Ye-Htet-Kyaw/Prototyping-D4-Abdelmalek-Kyaw-Forbi-Tchouteng/media/Wiring/1000001931.jpg

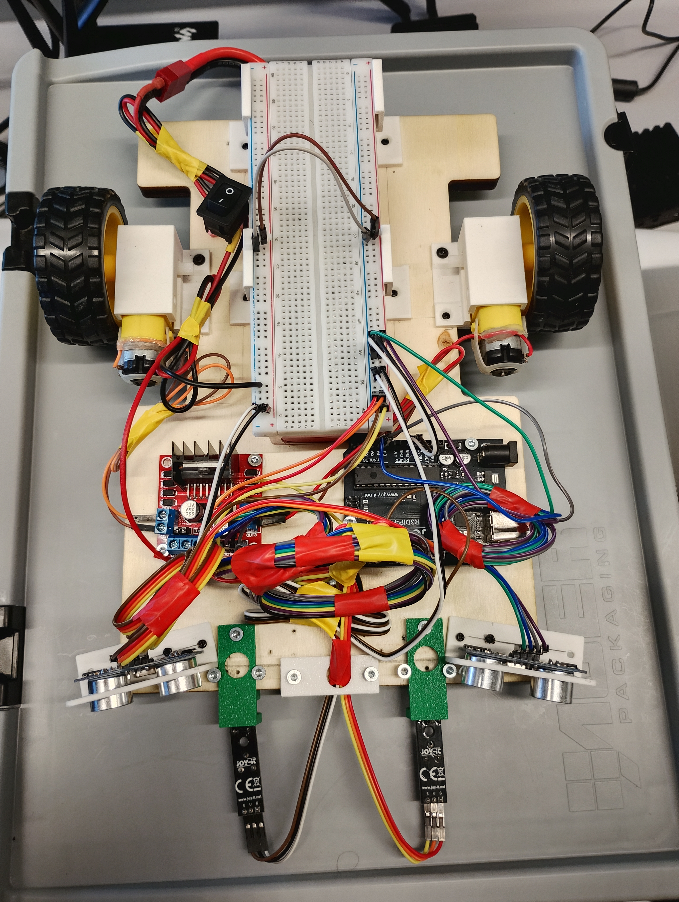
media/Wiring/1000001931.jpg
