Ye-Htet-Kyaw/Prototyping-D4-Abdelmalek-Kyaw-Forbi-Tchouteng/media/Wiring/part 2/IMG_7180.jpeg

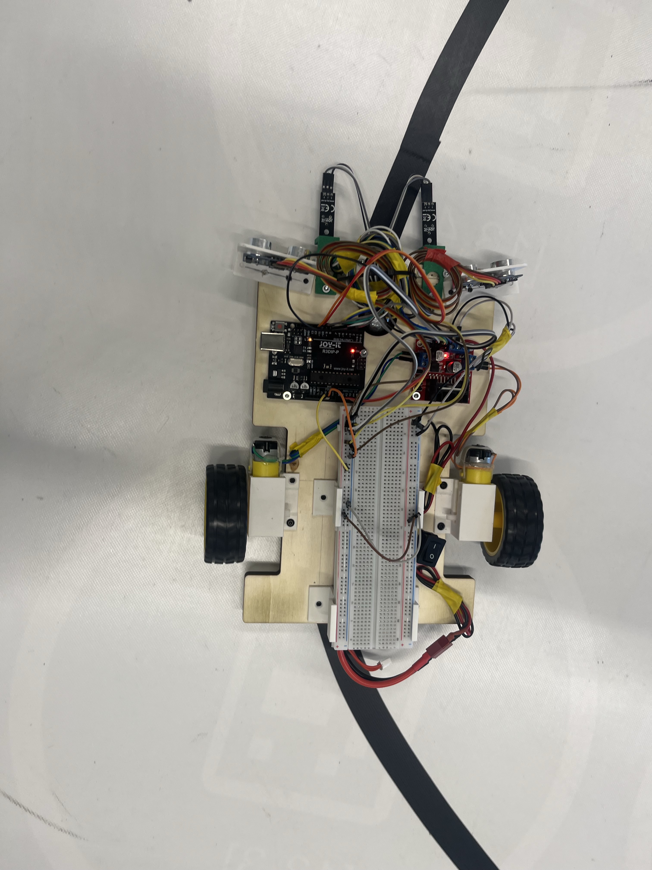
media/Wiring/part 2/IMG_7180.jpeg
