Ye-Htet-Kyaw/Prototyping-D4-Abdelmalek-Kyaw-Forbi-Tchouteng/Firmware and Simulation/README.md

# Module Definitions

| Module | Responsibility |
| :--- | :--- |
| **`RobotCar.ino`** | Main entry point; acts as the high-level task scheduler. |
| **`LineFollow.cpp`** | Contains the state machine logic for track navigation (Rules 1-4). |
| **`Obstacle.cpp`** | Manages complex maneuver sequences and obstacle avoidance states. |
| **`Motors.cpp`** | Low-level hardware driver; handles PWM and H-bridge signals. |
| **`Sensors.cpp`** | Interface for Ultrasonic and IR sensor data acquisition. |
| **`Config.h`** | Centralized constants (pins, speeds, thresholds, timing). |
