Ye-Htet-Kyaw/Prototyping-D4-Abdelmalek-Kyaw-Forbi-Tchouteng/CAD/Battery & Board/README.txt

Battery & Breadboard Holder – Work In Progress...

Current progress images of the custom CAD-designed holder for the breadboard and battery integration.

Initial geometry and mounting structure have been completed using CAD O-Shape for concept development.

Final refined version, including SolidWorks source files and exported STEP/STL manufacturing files, will be uploaded within the next 1–2 days.
