Ye-Htet-Kyaw/Prototyping-D4-Abdelmalek-Kyaw-Forbi-Tchouteng/CAD/Battery & Board/Battery_Board_Holder_Final_RevA/README.txt

Tolerance-adjusted final revision for improved component fit and assembly clearance.

Files:
- SLDPRT: Native SolidWorks model
- STL: 3D-printable mesh
- STEP: Neutral CAD exchange format

Minor dimensional tolerances were added to improve breadboard and battery accommodation.
