Ye-Htet-Kyaw/Prototyping-D4-Abdelmalek-Kyaw-Forbi-Tchouteng/docs/Final Presentation docs/first_draft/Team_D4.pptx

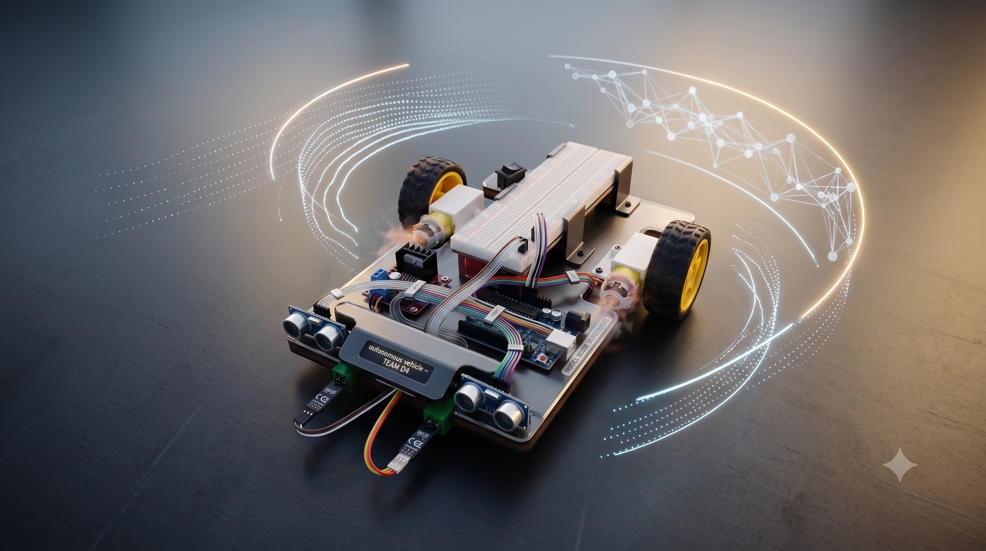
[picture p25: figure]

## Slide 2

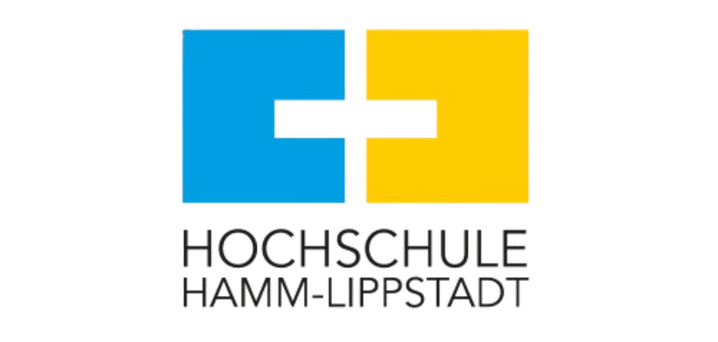
[picture p26: figure]

ELECTRICAL ENGINEERING | ELE

DESIGN AND IMPLEMENTATION OF AN AUTONOMOUS LINE-FOLLOWING AND OBSTACLE-AVOIDING ROBOT

Presented by ;

  - Dodly Forbi
  - Ye-Htet_Kyaw
  - Gabriel Tchakunte
  - Abdelmalek Abraham

ELE Systems Engineering SS2026

## Slide 3

Slide 1

PRESENTATION OUTLINE

  - Project objectives & Requirements
  - System Engineering View
  - Hardware and Mechanical Design
  - Software and Control Logic
  - UML Diagrams
  - Testing and Results
  - Conclusion
  - Future Work

## Slide 4

Slide 2

PROJECT OBJECTIVES & REQUIREMENTS

OBJECTIVES

  - Line Following

Follow straight and curved tracks

  - Obstacle Detection and varied behaviour ;

Perform alternating responses such as obstacle dodging and 180° turn

CONSTRAINTS

  - Arduino Uno only

  - Kit Components only including ;

  - A pair of Ultrasonic & IR sensors, L298N motor driver , 2 motors, breadboard , screws, wires and a custom chassis

  - Custom track
  - Environment

## Slide 5

Slide 3

SYSTEM ENGINEERING VIEW

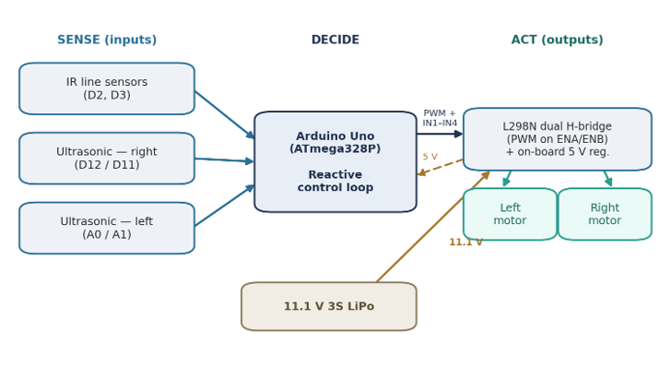
[picture p27: figure]

Inputs
  - 2× IR sensors
  - 2× HC-SR04 sensors
Controller
  - Arduino Uno
Outputs
  - L298N motor driver
  - Differential drive motors
Power
  - 11.1V LiPo

## Slide 6

ELECTRICAL ENGINEERING | ELE

Slide 4

HARDWARE AND MECHANICAL DESIGN

Presented by ;

  - Dodly Forbi
  - Ye-Htet_Kyaw
  - Gabriel Tchakunte
  - Abdelmalek Abraham

ELE Systems Engineering SS2026

## Slide 7

HARDWARE IMPLEMENTATION (1/5)

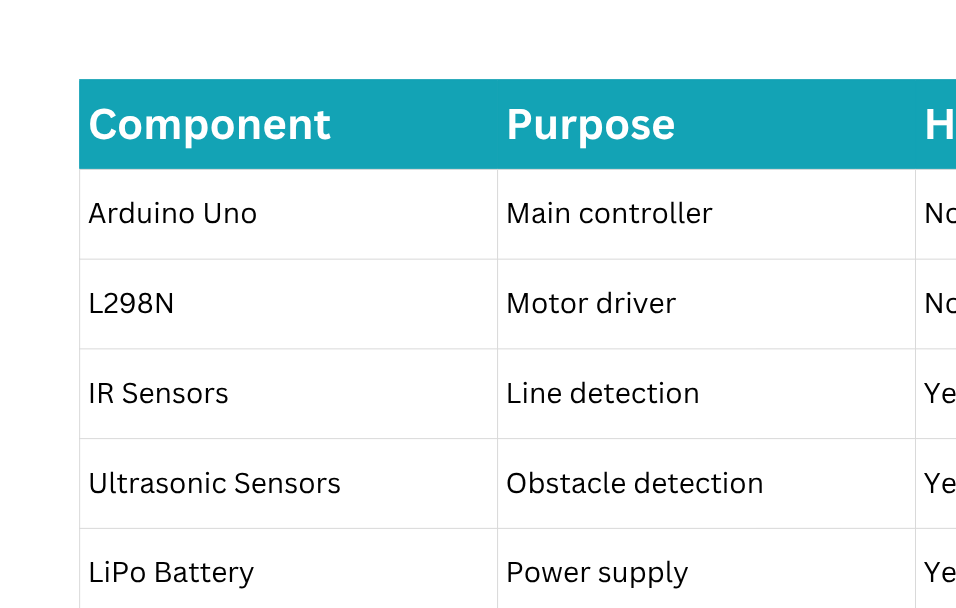
[picture p28: figure]

Slide 5

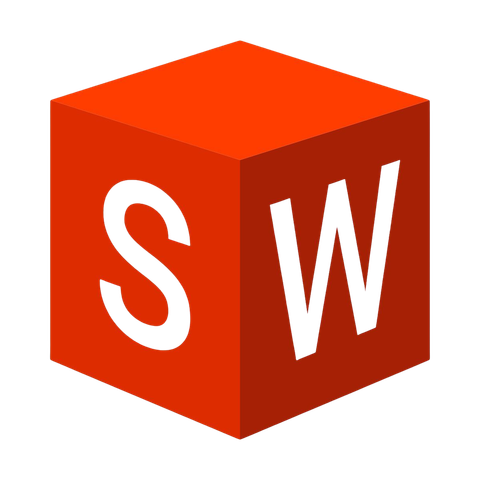
[picture p29: figure]
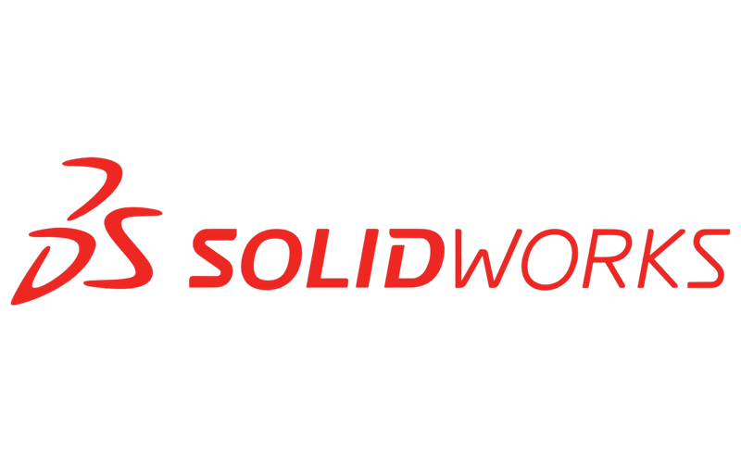
[picture p30: figure]

Mounts and Holders were designed on SolidWorks and then printed

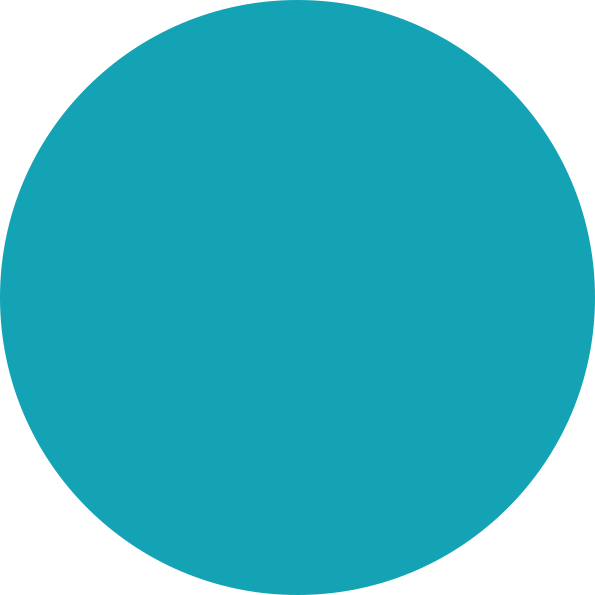
[picture p31: figure]

## Slide 8

HARDWARE IMPLEMENTATION (2/5)

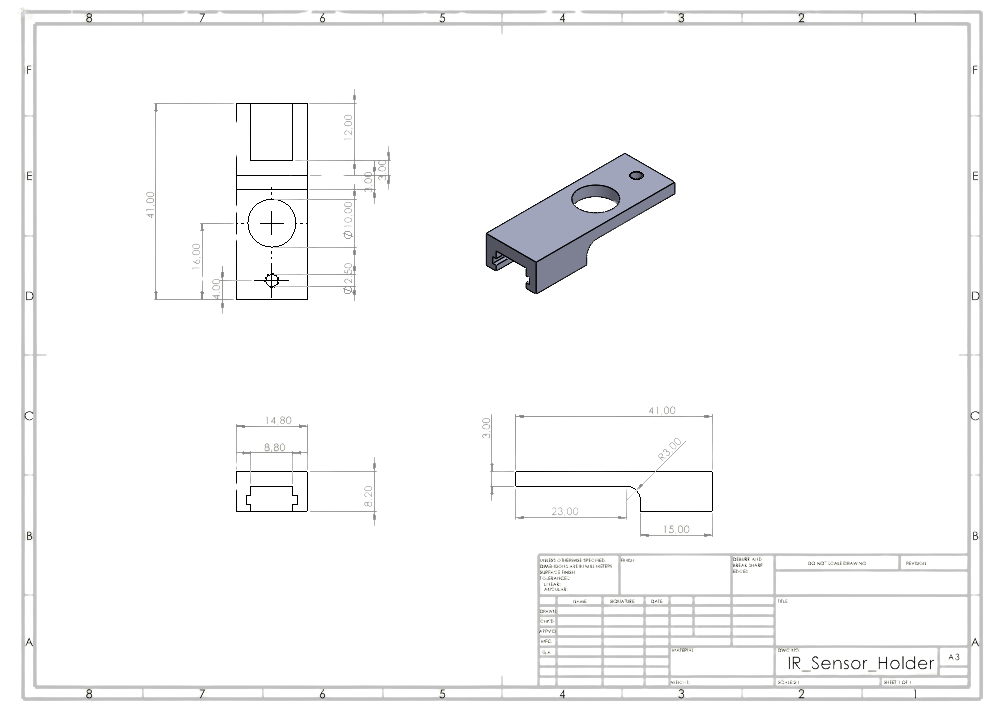
[picture p32: figure]

Slide 6

  - IR sensor Holder

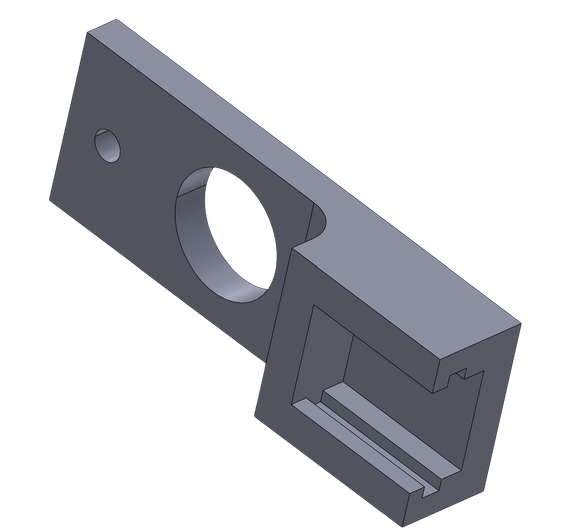
[picture p33: figure]

Ye

Ye Htet Tchew

## Slide 9

HARDWARE IMPLEMENTATION (3/5)

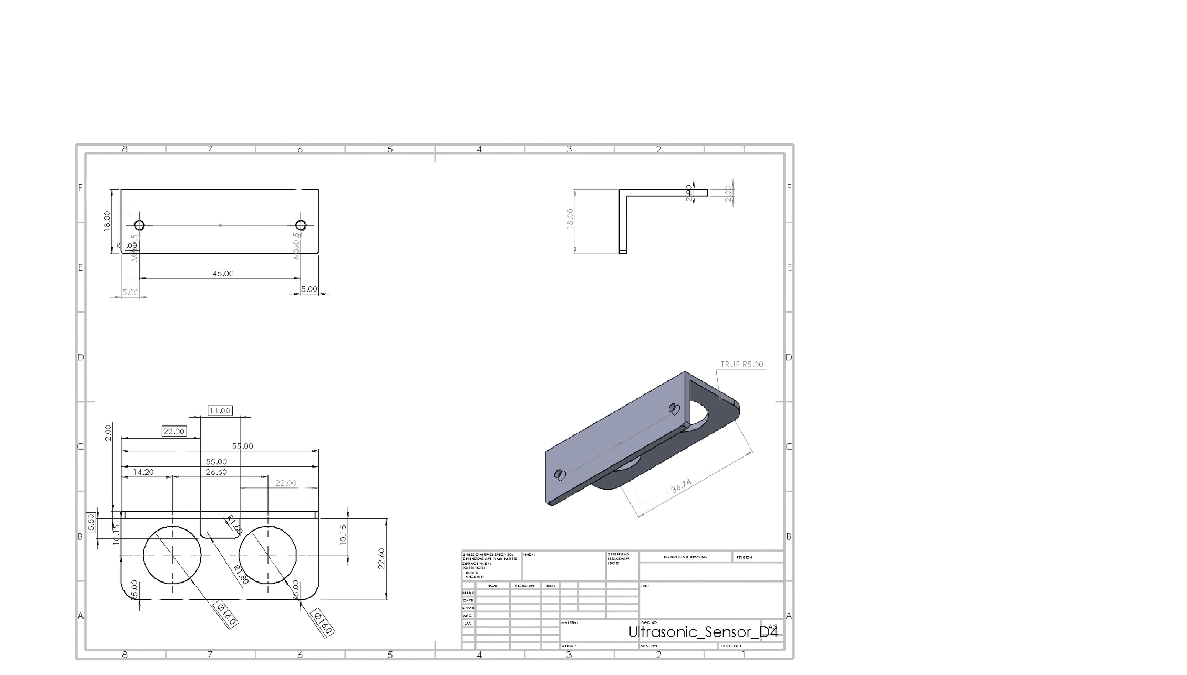
[picture p34: figure]

Slide 7

  - Ultrasonic Sensor Holder

Gabriel Tchakunte

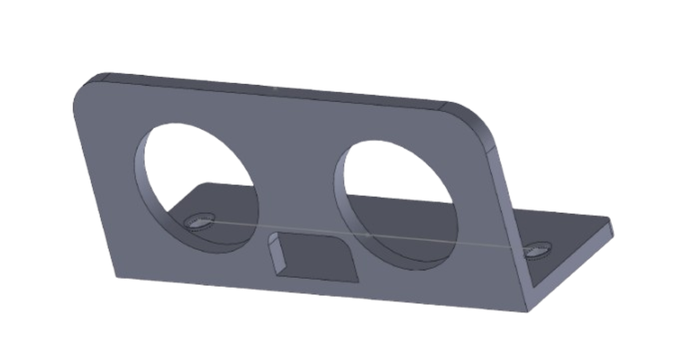
[picture p35: figure]
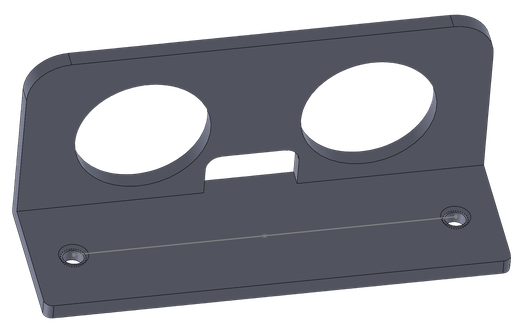
[picture p36: figure]

## Slide 10

HARDWARE IMPLEMENTATION (4/5)

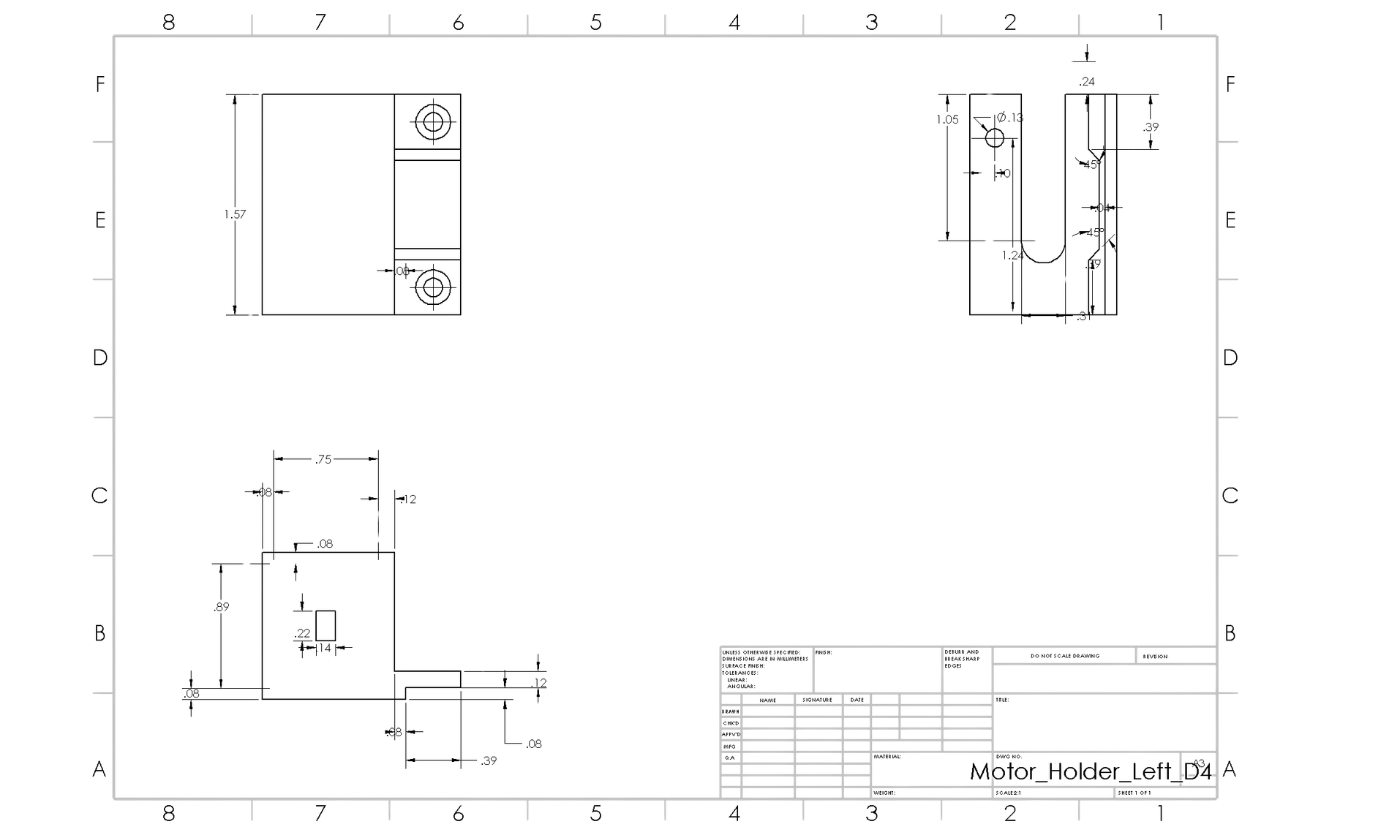
[picture p37: figure]

Slide 8

  - Ultrasonic Sensor

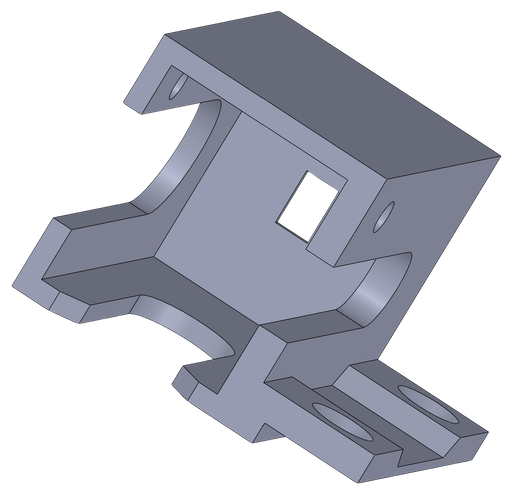
[picture p38: figure]

Abdelmalek Abraham

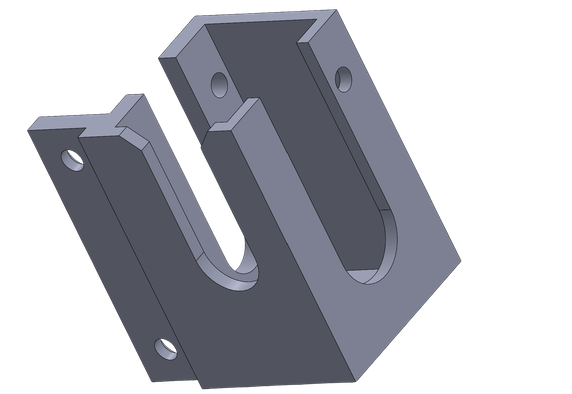
[picture p39: figure]

## Slide 11

HARDWARE IMPLEMENTATION (5/5)

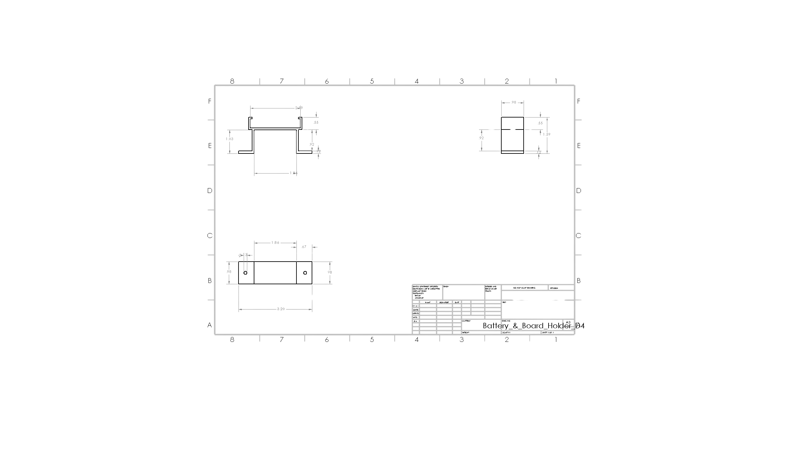
[picture p40: figure]

Slide 9

  - Battery/Breadboard Holder

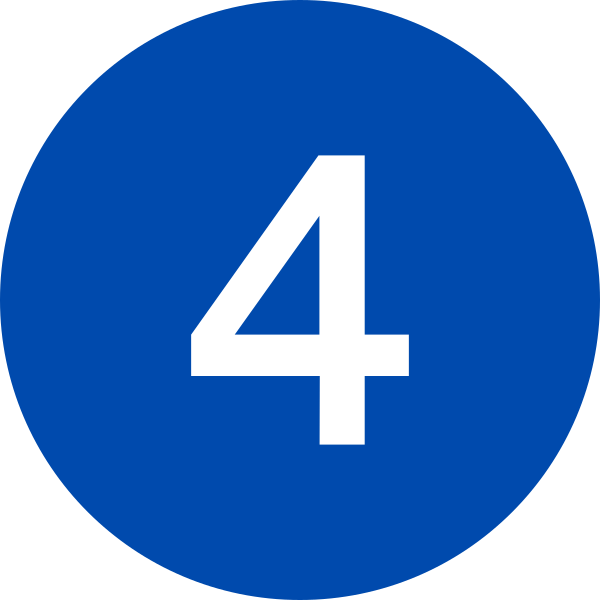
[picture p41: figure]
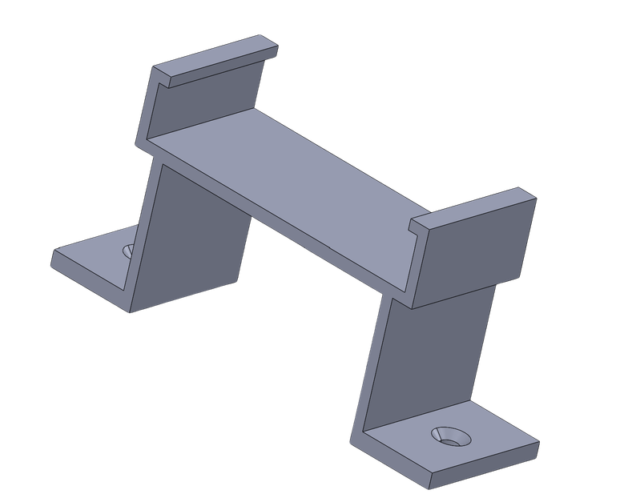
[picture p42: figure]
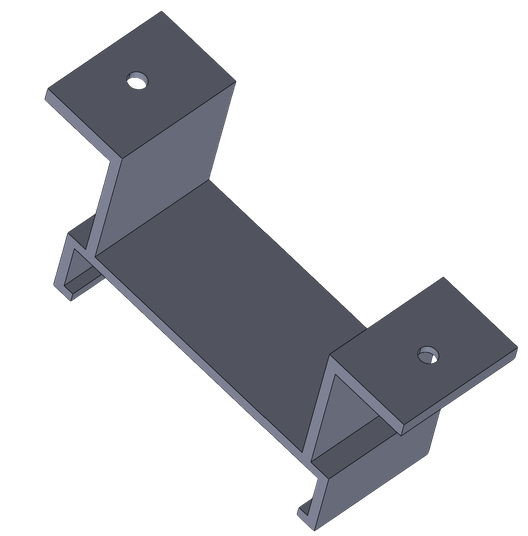
[picture p43: figure]

Dodly Forbi

## Slide 12

SOFTWARE & CONTROL LOGIC (1/3)

Slide 10

  - Two ultrasonic sensors checked every 60 ms
  - Closest distance triggers obstacle response at 12 cm
  - is180 alternates V-dogleg and 180° turn

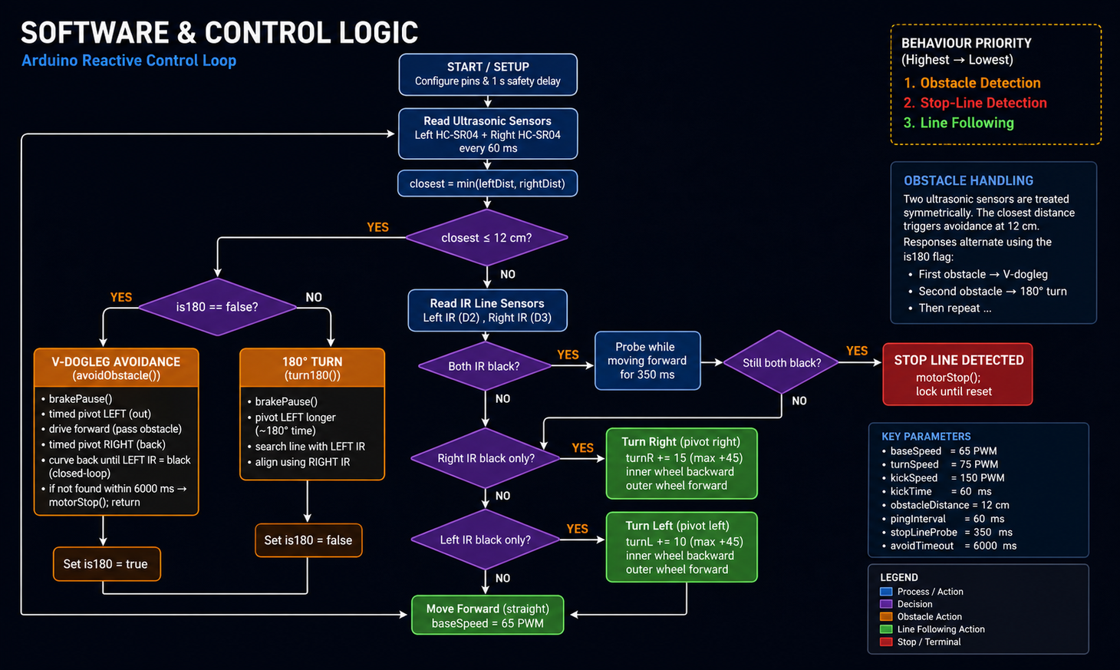
[picture p44: figure]
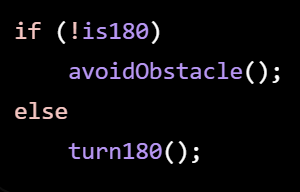
[picture p45: figure]

## Slide 13

SOFTWARE & CONTROL LOGIC (2/3)

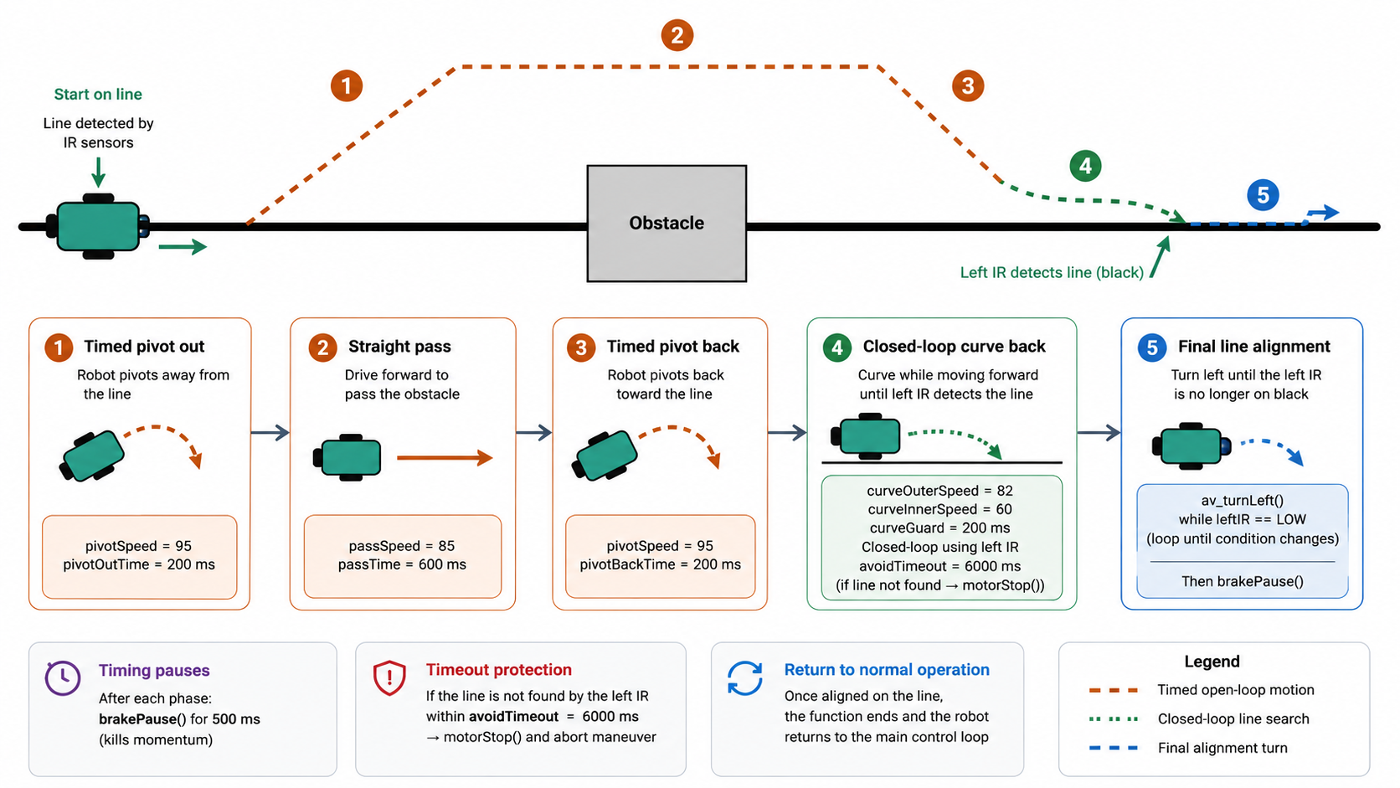
[picture p46: figure]

Slide 11

  - V dogleg dodge

## Slide 14

SOFTWARE & CONTROL LOGIC (3/3)

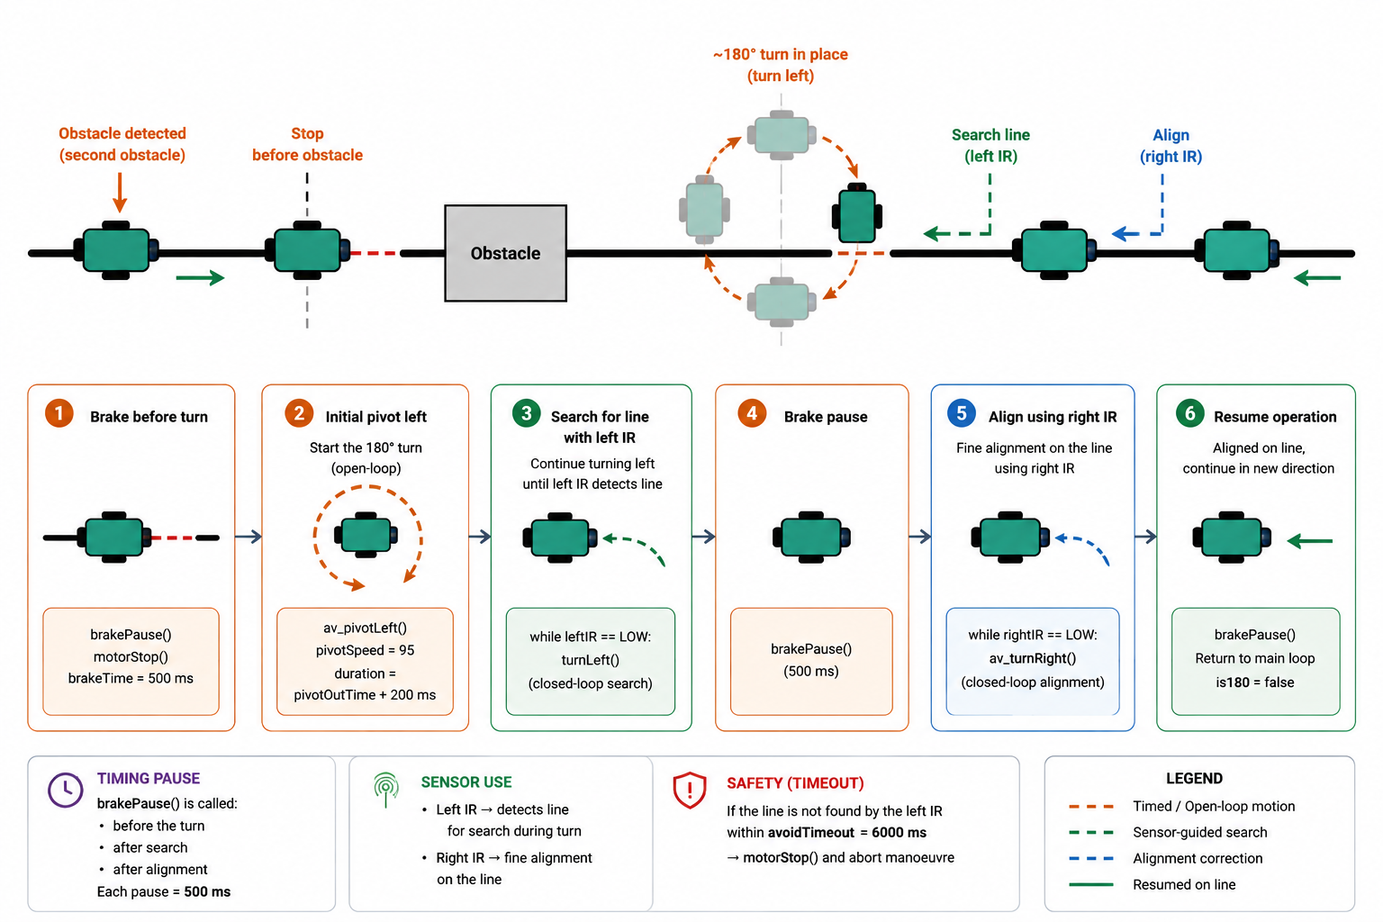
[picture p47: figure]

Slide 12

  - 180° turn

## Slide 15

ELECTRICAL ENGINEERING | ELE

Slide 13

UML DIAGRAMS

Presented by ;

  - Dodly Forbi
  - Ye-Htet_Kyaw
  - Gabriel Tchakunte
  - Abdelmalek Abraham

ELE Systems Engineering SS2026

## Slide 16

USE CASE DIAGRAM

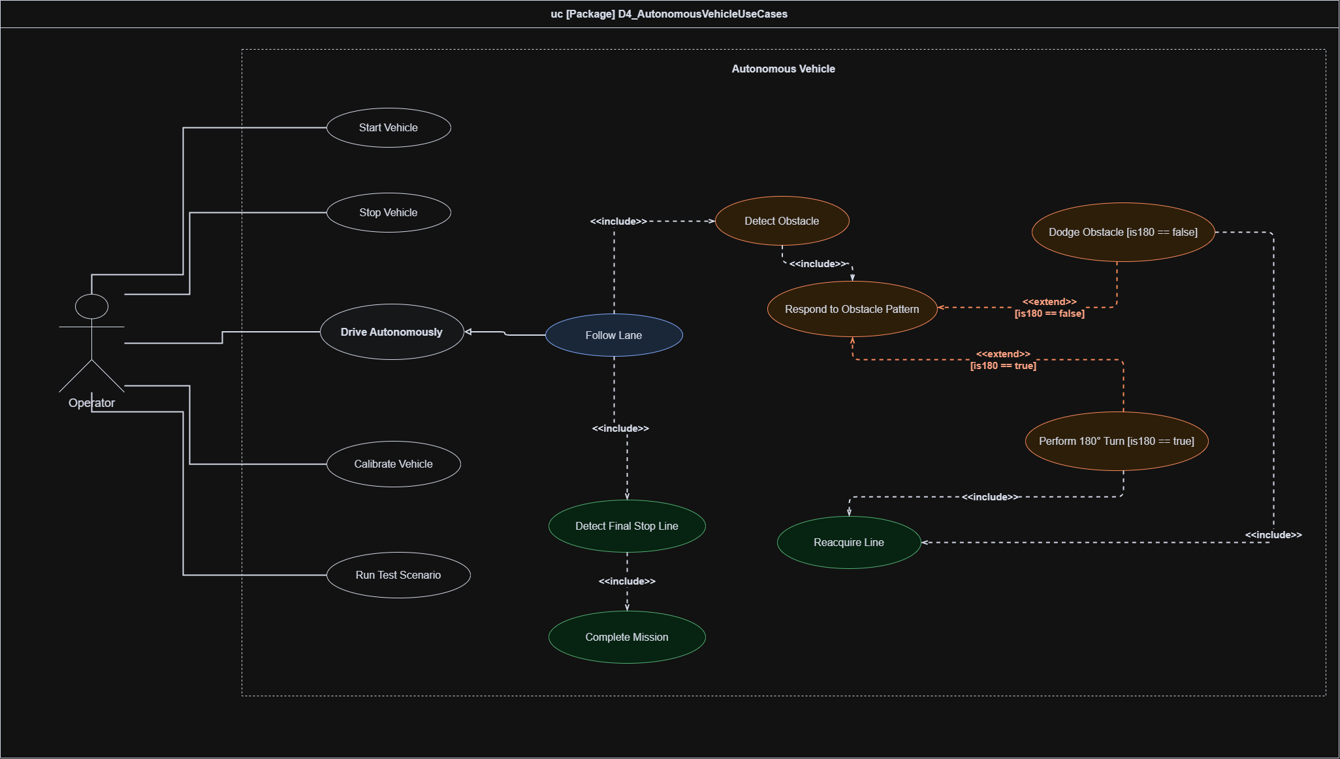
[picture p48: figure]

Slide 14

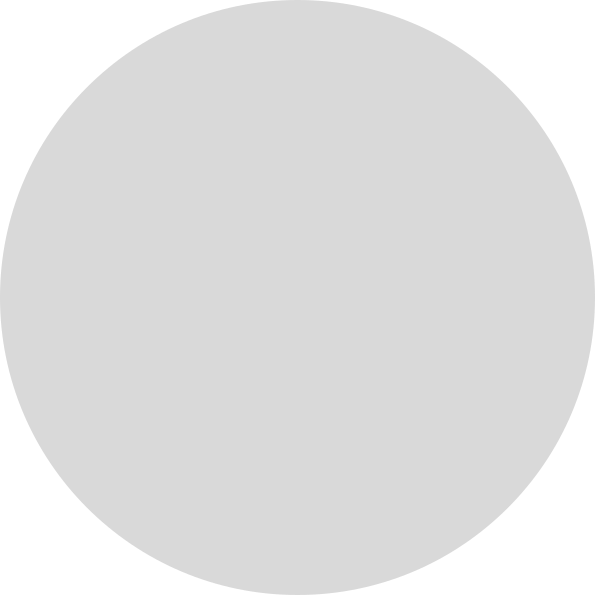
[picture p49: figure]
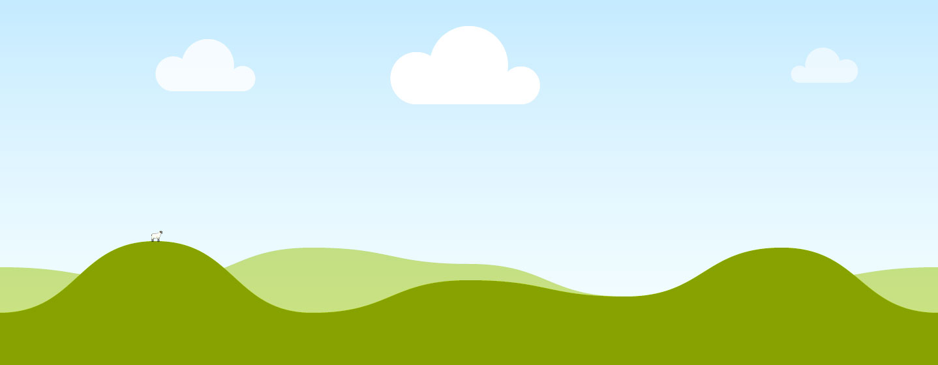
[picture p50: figure]

## Slide 17

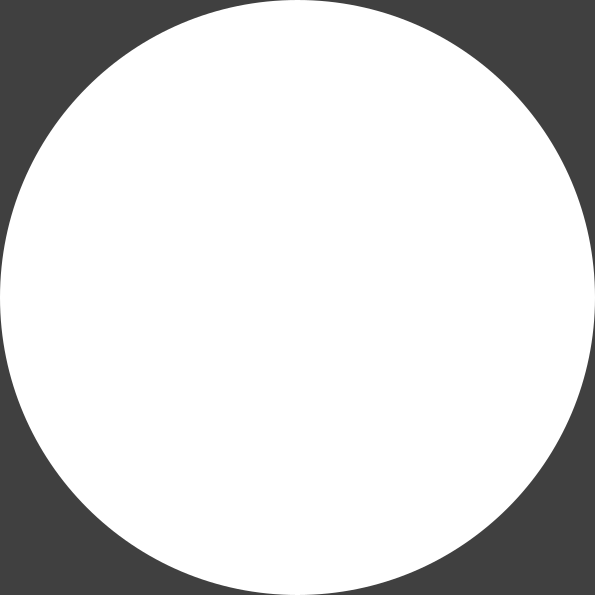
[picture p51: figure]

Slide 15

STATE MACHINE
DIAGRAM

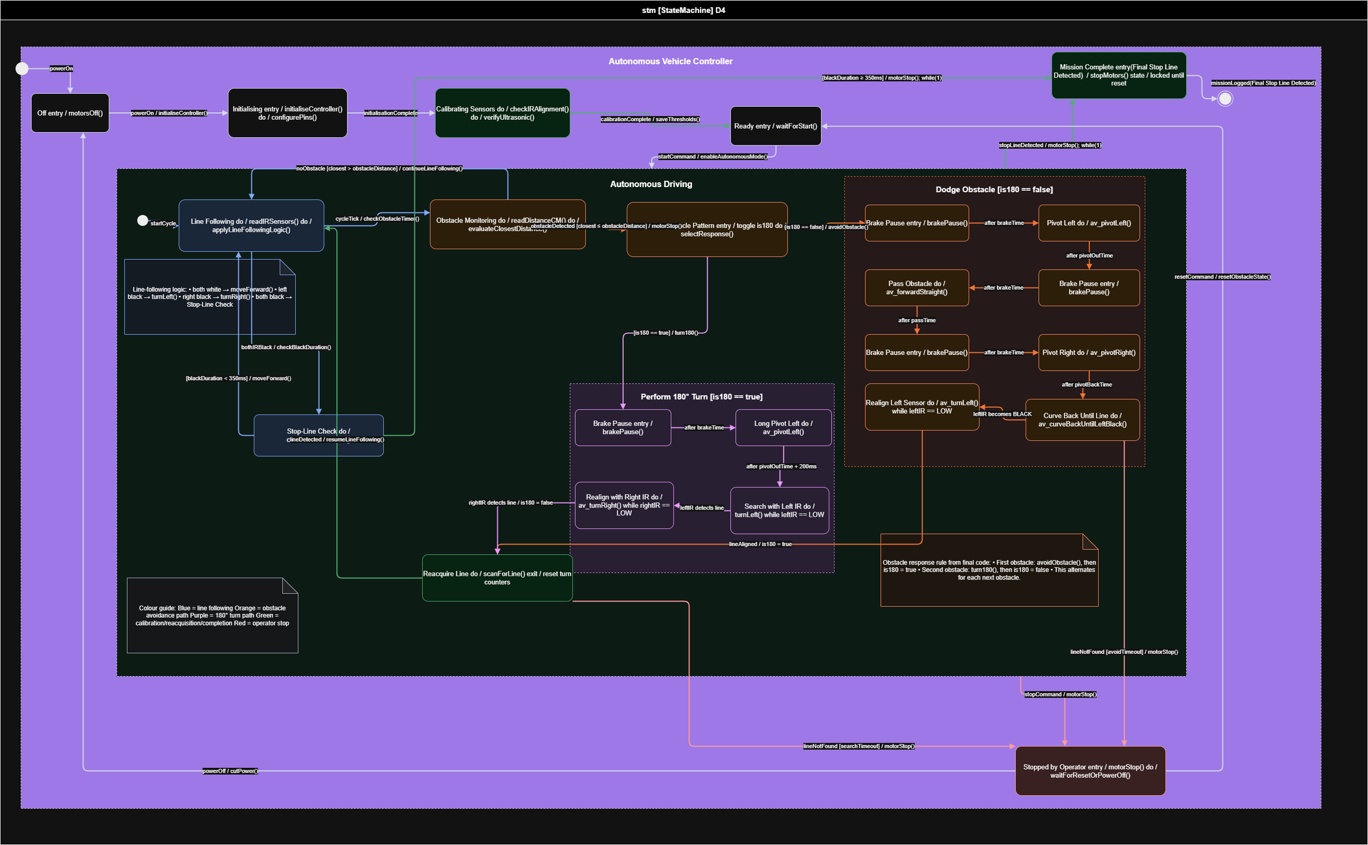
[picture p52: figure]

## Slide 18

ACTIVITY DIAGRAM

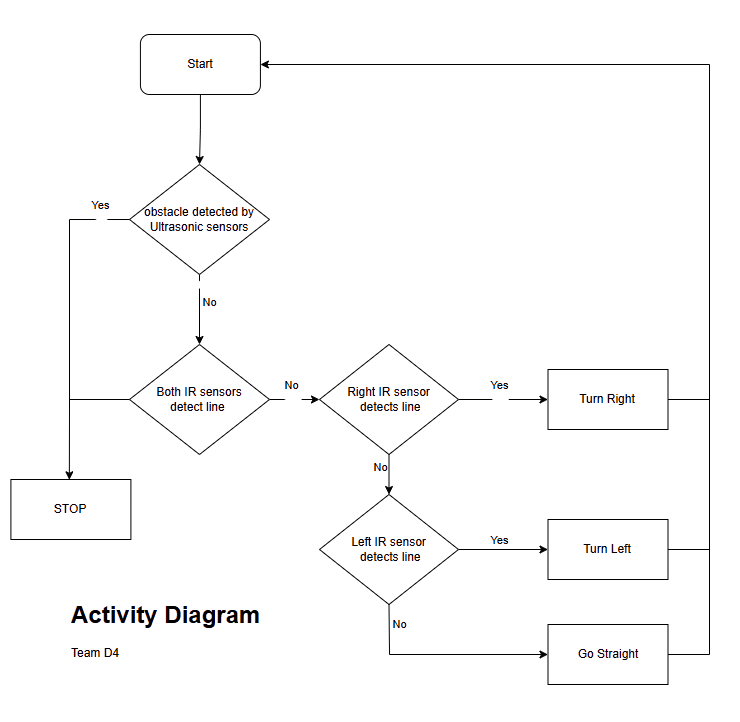
[picture p53: figure]

Slide 16

## Slide 19

PACKAGE DIAGRAM

Slide 17

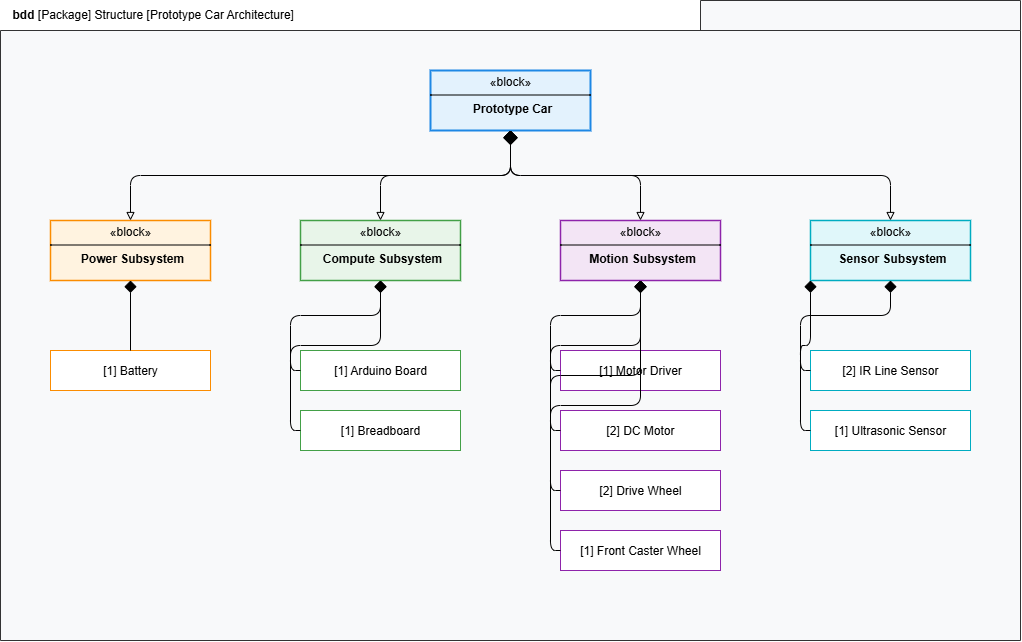
[picture p54: figure]

## Slide 20

BLOCK COMPONENT DIAGRAM

Slide 18

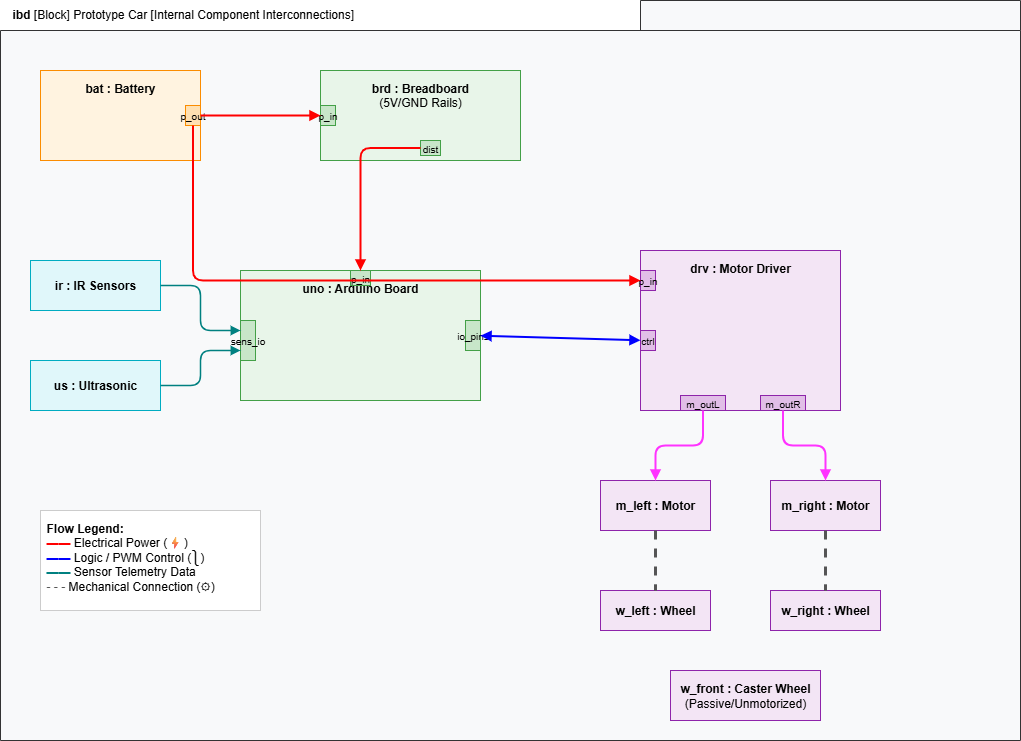
[picture p55: figure]

## Slide 21

SEQUENCE DIAGRAM

Slide 19

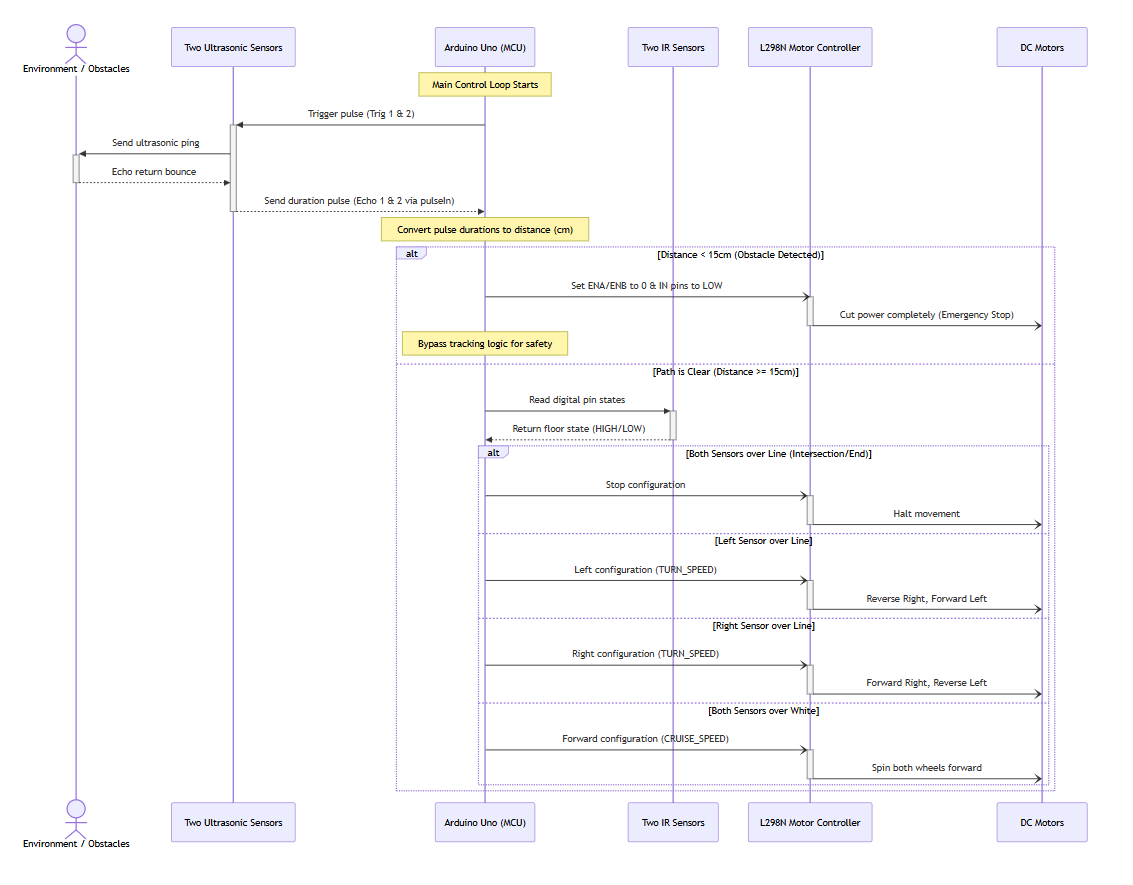
[picture p56: figure]

## Slide 22

TESTING & RESULTS

Slide 20

Test Photo #1

Test Photo #2

Test Photo #3

## Slide 23

TESTING & RESULTS (2/2)

Slide 21

RESULTS

  - Motor completed track in 48secs without obstacle manoeuvring
  - Static friction required kick-start PWM.
  - Physical testing outperformed simulation.
  - Sensor placement mattered more than expected.
  - Mechanical robustness required multiple redesigns.

## Slide 24

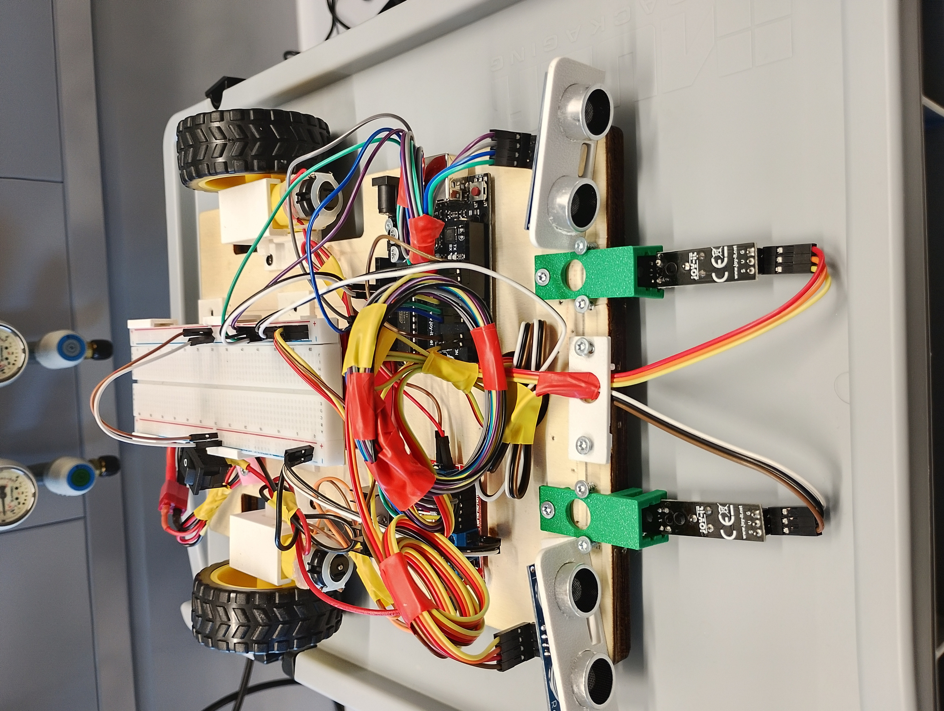
[picture p57: figure]

CONCLUSIONS

ACHIEVEMENTS

✅Met all objectives
✅ Used only project-kit hardware
✅ Reliable autonomous behaviour
✅ Complete documentation
✅ Team Collaboration on Github

Slide 22

## Slide 25

Slide 23

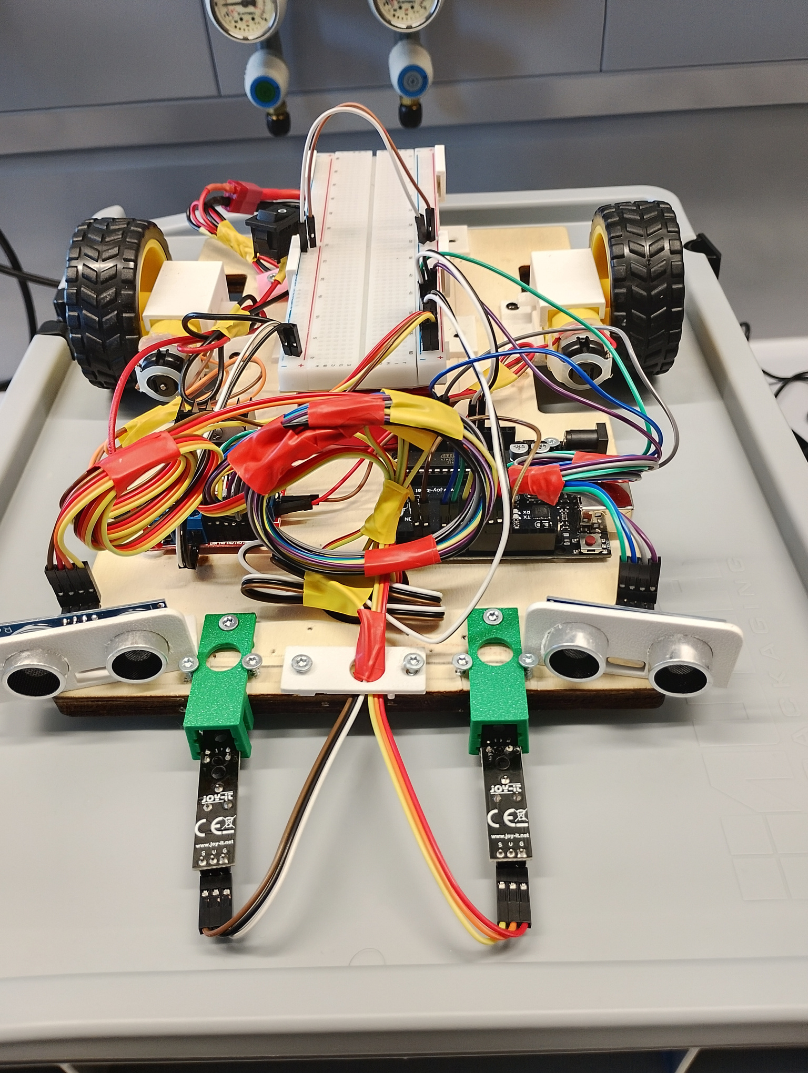
[picture p58: figure]

FUTURE WORK

  - PID line following
  - Wheel encoders
  - Adaptive IR calibration
  - Vision-based navigation

## Slide 26

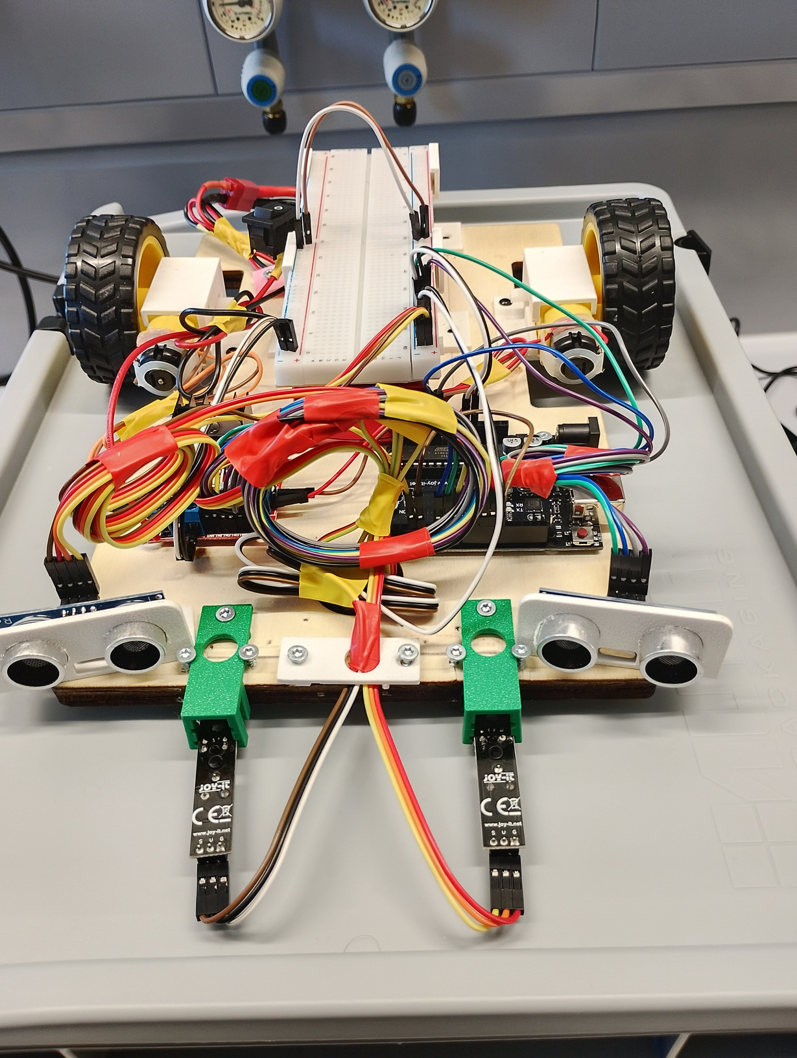
[picture p59: figure]

Thank
You

for your keen attention.

Questions , comments ?
