Ye-Htet-Kyaw/Prototyping-D4-Abdelmalek-Kyaw-Forbi-Tchouteng/Tasks/Splitings_Tasks.md

<table border="1" style="border-collapse: collapse; width: 100%; font-family: Arial, sans-serif; font-size: 14px;">
  <thead>
    <tr>
      <th style="padding: 10px; text-align: center;"></th>
      <th style="padding: 10px; text-align: center;"></th>
      <th style="padding: 10px; text-align: center;"></th>
      <th style="padding: 10px; text-align: center;" colspan="2">Ye Htet Kyaw</th>
      <th style="padding: 10px; text-align: center;" colspan="2">Ibrahim Abdelmalek</th>
      <th style="padding: 10px; text-align: center;" colspan="2">Dodly Forbi</th>
      <th style="padding: 10px; text-align: center;" colspan="2">Gabriel Tchakunte Tchouteng</th>
    </tr>
  </thead>
  <tbody>
    <tr>
      <td style="padding: 10px; text-align: center;">Number</td>
      <td style="padding: 10px; text-align: center;">Task</td>
      <td style="padding: 10px; text-align: center;">Short Summary</td>
      <td style="padding: 10px; text-align: center;">To Do <br>(Dead line)</td>
      <td style="padding: 10px; text-align: center;">Finishing Date</td>
      <td style="padding: 10px; text-align: center;">To Do <br>(Dead line)</td>
      <td style="padding: 10px; text-align: center;">Finishing Date</td>
      <td style="padding: 10px; text-align: center;">To Do <br>(Dead line)</td>
      <td style="padding: 10px; text-align: center;">Finishing Date</td>
      <td style="padding: 10px; text-align: center;">To Do <br>(Dead line)</td>
      <td style="padding: 10px; text-align: center;">Finishing Date</td>
    </tr>
    <tr>
      <td style="padding: 10px; text-align: center;">1</td>
      <td style="padding: 10px; text-align: center;">Holder designs</td>
      <td style="padding: 10px; text-align: center;">3D printed holders using SolidWorks</td>
      <td style="padding: 10px; text-align: center;">Ir Sensor Holder<br>(7 May)</td>
      <td style="padding: 10px; text-align: center;">6 May</td>
      <td style="padding: 10px; text-align: center;">Motor Holder left and right<br>(7 May)</td>
      <td style="padding: 10px; text-align: center;">6 May</td>
      <td style="padding: 10px; text-align: center;">Battery and Broad Board Holder<br>(7 May)</td>
      <td style="padding: 10px; text-align: center;">6 May</td>
      <td style="padding: 10px; text-align: center;">Ultrasonic Holder<br>(7 May)</td>
      <td style="padding: 10px; text-align: center;">6 May</td>
    </tr>
    <tr>
      <td style="padding: 10px; text-align: center;">2</td>
      <td style="padding: 10px; text-align: center;">Task 1:System Modelling</td>
      <td style="padding: 10px; text-align: center;">SysML Diagrams for better understanding and<br> describing of the system</td>
      <td style="padding: 10px; text-align: center;">Sequence Diagram + Activities Diagram<br>(24 May)</td>
      <td style="padding: 10px; text-align: center;">24 May</td>
      <td style="padding: 10px; text-align: center;">Requirement + Package Diagrams<br>(24 May)</td>
      <td style="padding: 10px; text-align: center;">24 May</td>
      <td style="padding: 10px; text-align: center;">State Machine + Use case Diagram<br>(24 May)</td>
      <td style="padding: 10px; text-align: center;">24 May</td>
      <td style="padding: 10px; text-align: center;">Block Definition + Internal Block Diagram<br>(24 May)</td>
      <td style="padding: 10px; text-align: center;">24 May</td>
    </tr>
    <tr>
      <td style="padding: 10px; text-align: center;">3</td>
      <td style="padding: 10px; text-align: center;">Task 2: Tinkercad Simulation</td>
      <td style="padding: 10px; text-align: center;">Validate circuit logic and sensor/actuator response through virtual prototyping</td>
      <td style="padding: 10px; text-align: center;">Simulation Firmware Implementation</td>
      <td style="padding: 10px; text-align: center;">24 May</td>
      <td style="padding: 10px; text-align: center;">Simulation Rewiew and using the tape for wiring to avoid spaghetti wiring</td>
      <td style="padding: 10px; text-align: center;">24 May</td>
      <td style="padding: 10px; text-align: center;">Simulation Firmware Implementation</td>
      <td style="padding: 10px; text-align: center;">24 May</td>
      <td style="padding: 10px; text-align: center;">Simulation Review</td>
      <td style="padding: 10px; text-align: center;">24 May</td>
    </tr>
    <tr>
      <td style="padding: 10px; text-align: center;">4</td>
      <td style="padding: 10px; text-align: center;">Task 3 - milestone 1: Line Following</td>
      <td style="padding: 10px; text-align: center;">Implement line-following algorithm and hardware integration</td>
      <td style="padding: 10px; text-align: center;">Final Firmware Implementation and <br>Hardware Verification Test in Lab</td>
      <td style="padding: 10px; text-align: center;">10 June</td>
      <td style="padding: 10px; text-align: center;">tried a working version at my place and posted on github</td>
      <td style="padding: 10px; text-align: center;">10 June</td>
      <td style="padding: 10px; text-align: center;">Firmware Review</td>
      <td style="padding: 10px; text-align: center;">10 June</td>
      <td style="padding: 10px; text-align: center;">Firmware Review</td>
      <td style="padding: 10px; text-align: center;">10 June</td>
    </tr>
    <tr>
      <td style="padding: 10px; text-align: center;">5</td>
      <td style="padding: 10px; text-align: center;">Task 3 - milestone 2: Obstacle avoidance</td>
      <td style="padding: 10px; text-align: center;">Implement obstacle avoidance logic and 180° turn maneuver</td>
      <td style="padding: 10px; text-align: center;">Final Firmware Implementation and<br>Hardware Verification Test in Lab</td>
      <td style="padding: 10px; text-align: center;">24 June</td>
      <td style="padding: 10px; text-align: center;">working on the Time controlling in the code, using the trouble shooting output which was posted on Github</td>
      <td style="padding: 10px; text-align: center;">24 June</td>
      <td style="padding: 10px; text-align: center;">Firmware Review</td>
      <td style="padding: 10px; text-align: center;">24 June</td>
      <td style="padding: 10px; text-align: center;">Firmware Review</td>
      <td style="padding: 10px; text-align: center;">24 June</td>
    </tr>
    <tr>
      <td style="padding: 10px; text-align: center;">6</td>
      <td style="padding: 10px; text-align: center;">Final Presentation</td>
      <td style="padding: 10px; text-align: center;">Deliver 5-minute technical presentation summarizing system objective, SML diagrams, firmware implementation, Physical optimization and performance results.</td>
      <td style="padding: 10px; text-align: center;">Presenting and Slide Design: Firmware Implementation <br> (06 July) </td>
      <td style="padding: 10px; text-align: center;">02 July</td>
      <td style="padding: 10px; text-align: center;">Presenting and Slide Design: Physical Optimization <br> (06 July) </td>
      <td style="padding: 10px; text-align: center;">02 July</td>
      <td style="padding: 10px; text-align: center;">Presenting and Slide Design: system objective and performance results <br> (06 July)</td>
      <td style="padding: 10px; text-align: center;">02 July</td>
      <td style="padding: 10px; text-align: center;">Presenting and Slide Design: SML diagrams <br> (06 July) </td>
      <td style="padding: 10px; text-align: center;">02 July</td>
    </tr>
    <tr>
      <td style="padding: 10px; text-align: center;">7</td>
      <td style="padding: 10px; text-align: center;">Final Report</td>
      <td style="padding: 10px; text-align: center;"> Technical documentation of system architecture, firmware analysis, and final project review.</td>
      <td style="padding: 10px; text-align: center;">Software/Control logic documentation, testing analysis, and final overall corrections <br> (26 July) </td>
      <td style="padding: 10px; text-align: center;">18 July</td>
      <td style="padding: 10px; text-align: center;"> Initial report drafting and Hardware design documentation, system challenges analysis <br> (26 July) </td>
      <td style="padding: 10px; text-align: center;">18 July</td>
      <td style="padding: 10px; text-align: center;">Proofreading, Hardware/System design review, and test/challenges content refinement</td>
      <td style="padding: 10px; text-align: center;">18 July</td>
      <td style="padding: 10px; text-align: center;">Proofreading and comprehensive report review<br> (26 July)</td>
      <td style="padding: 10px; text-align: center;">18 July</td>
    </tr>

  </tbody>
</table>
