Ye-Htet-Kyaw/Prototyping-D4-Abdelmalek-Kyaw-Forbi-Tchouteng/CAD/Battery & Board/Battery_Breadboard_Holder_WIP_View3.png

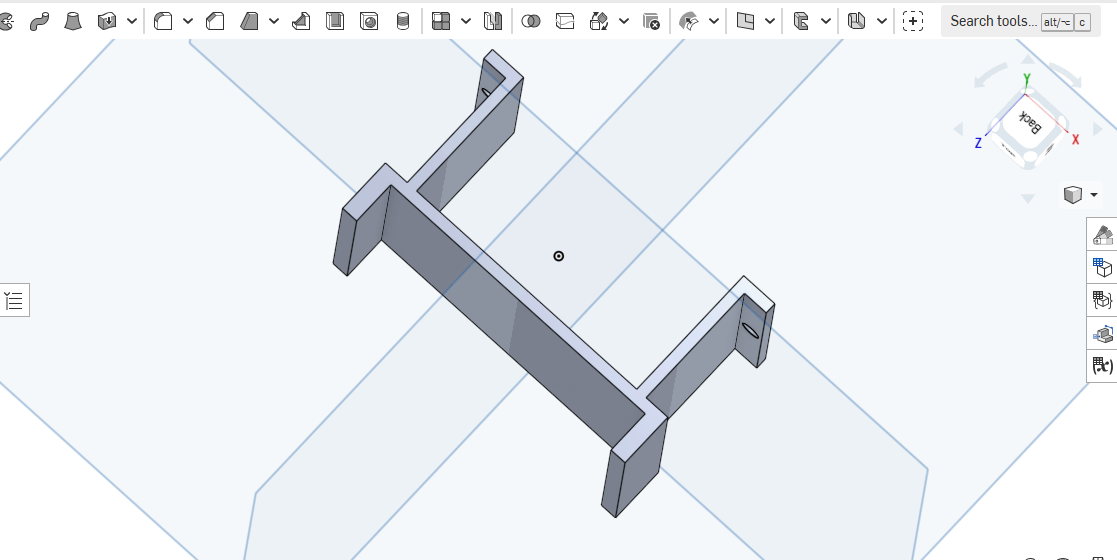
CAD/Battery & Board/Battery_Breadboard_Holder_WIP_View3.png
