Ye-Htet-Kyaw/Prototyping-D4-Abdelmalek-Kyaw-Forbi-Tchouteng/CAD/IR Sensor/IR_Sensors_Holder_D4.png

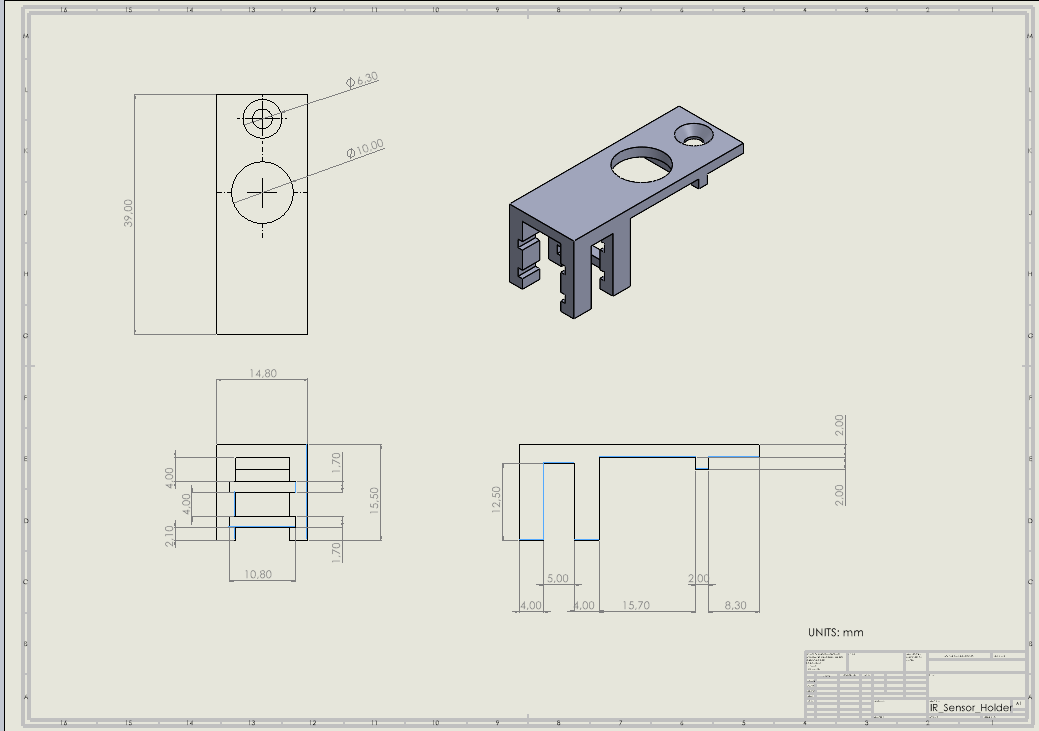
CAD/IR Sensor/IR_Sensors_Holder_D4.png
