Ye-Htet-Kyaw/Prototyping-D4-Abdelmalek-Kyaw-Forbi-Tchouteng/Diagrams/Activity_Diagram/Activity_Diagram_D4.png

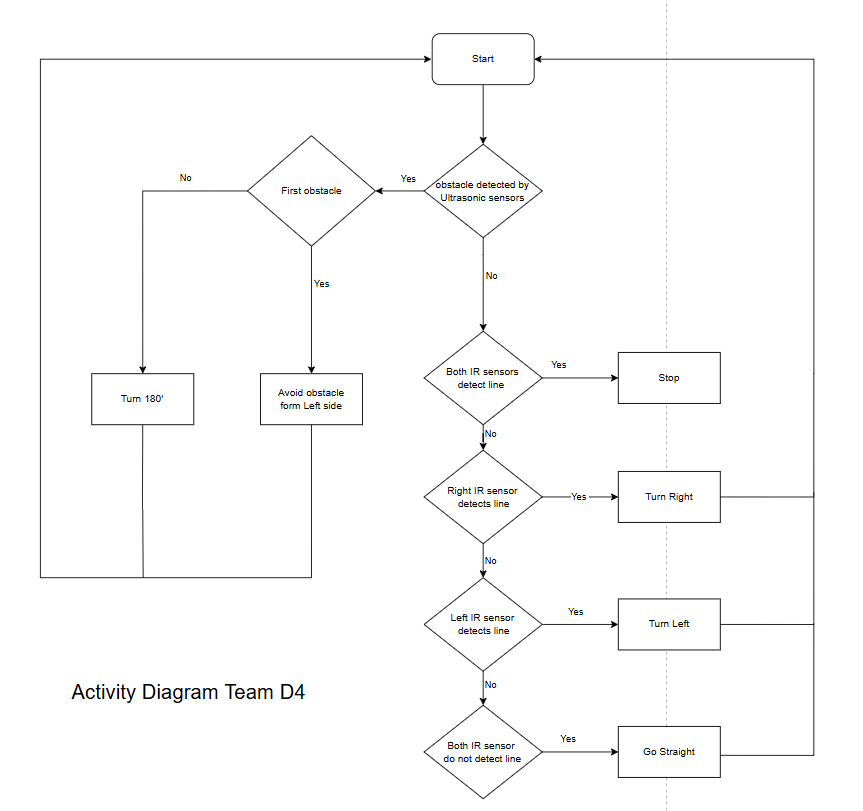
Diagrams/Activity_Diagram/Activity_Diagram_D4.png
