Ye-Htet-Kyaw/Prototyping-D4-Abdelmalek-Kyaw-Forbi-Tchouteng/Diagrams/Block_Definition_Diagram/Diagram realisation.drawio.png

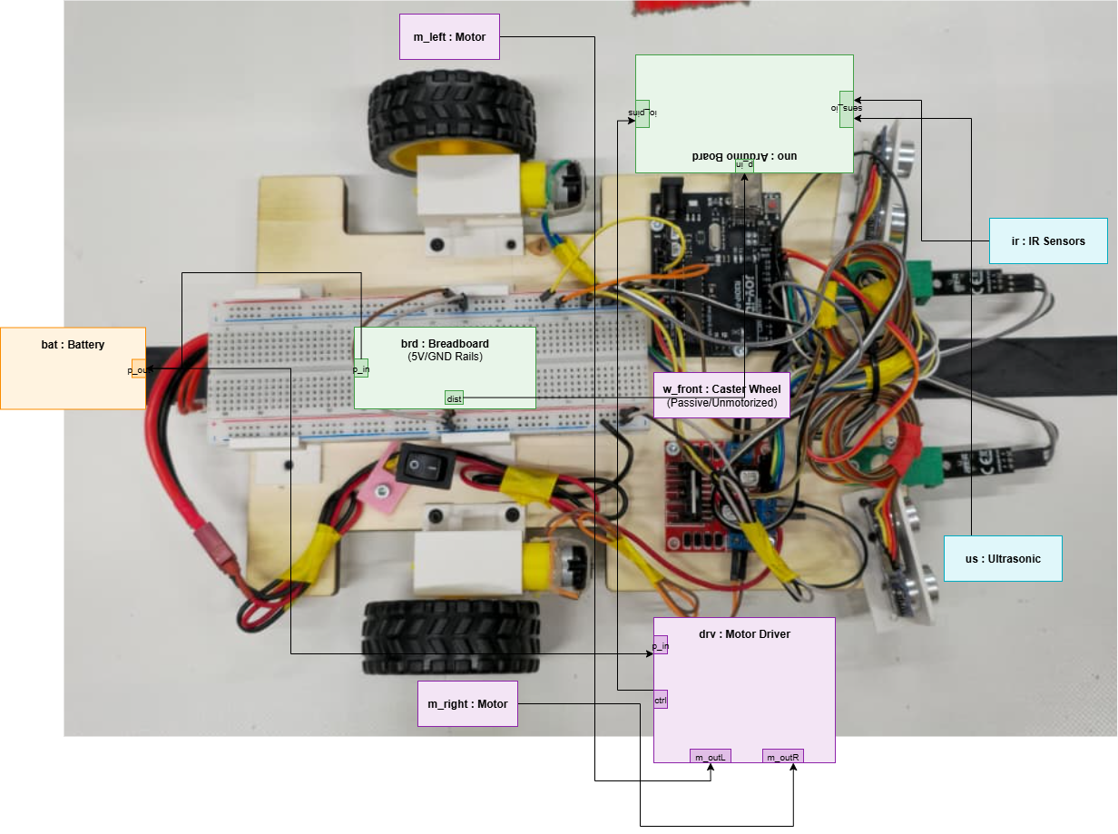
Diagrams/Block_Definition_Diagram/Diagram realisation.drawio.png
