Ye-Htet-Kyaw/Prototyping-D4-Abdelmalek-Kyaw-Forbi-Tchouteng/Diagrams/Sequence_Diagram/Sequence_Diagram_D4.png

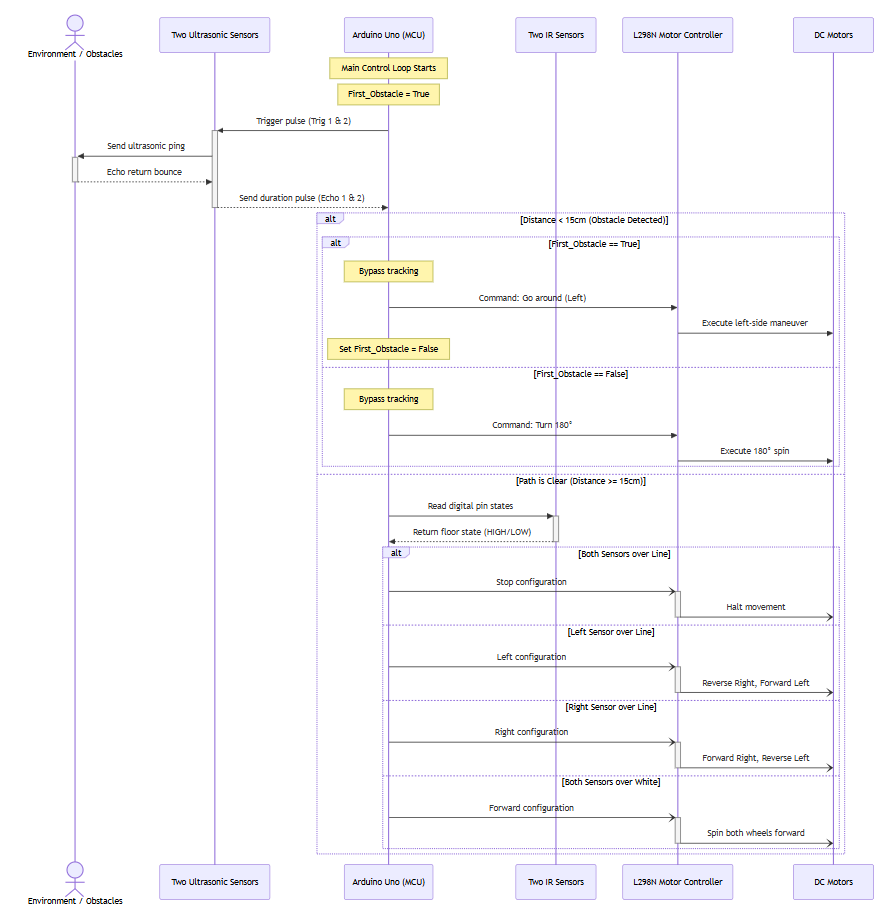
Diagrams/Sequence_Diagram/Sequence_Diagram_D4.png
