Ye-Htet-Kyaw/Prototyping-D4-Abdelmalek-Kyaw-Forbi-Tchouteng/Diagrams/State Machine Diagram/D4_StateMachine_Updated.drawio.png

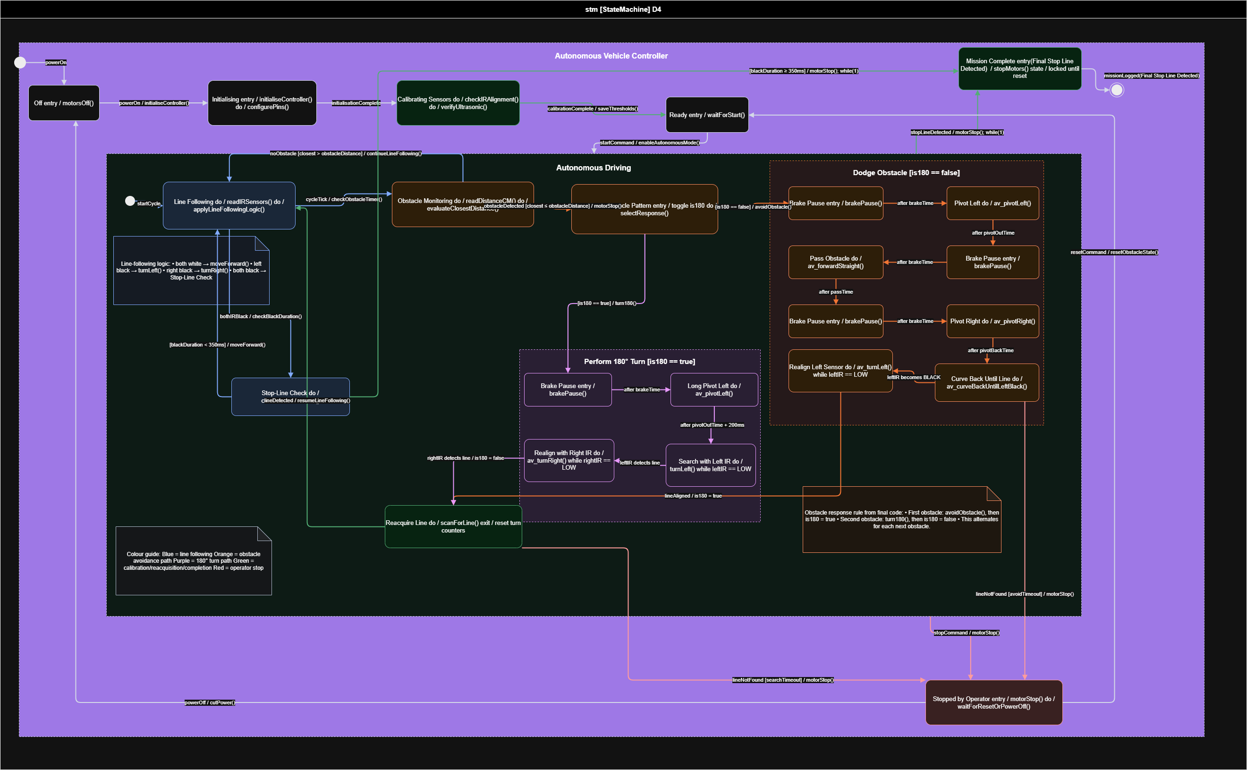
Diagrams/State Machine Diagram/D4_StateMachine_Updated.drawio.png
