Ye-Htet-Kyaw/Prototyping-D4-Abdelmalek-Kyaw-Forbi-Tchouteng/Diagrams/use_case-diagram/use_Case-D4.drawio.png

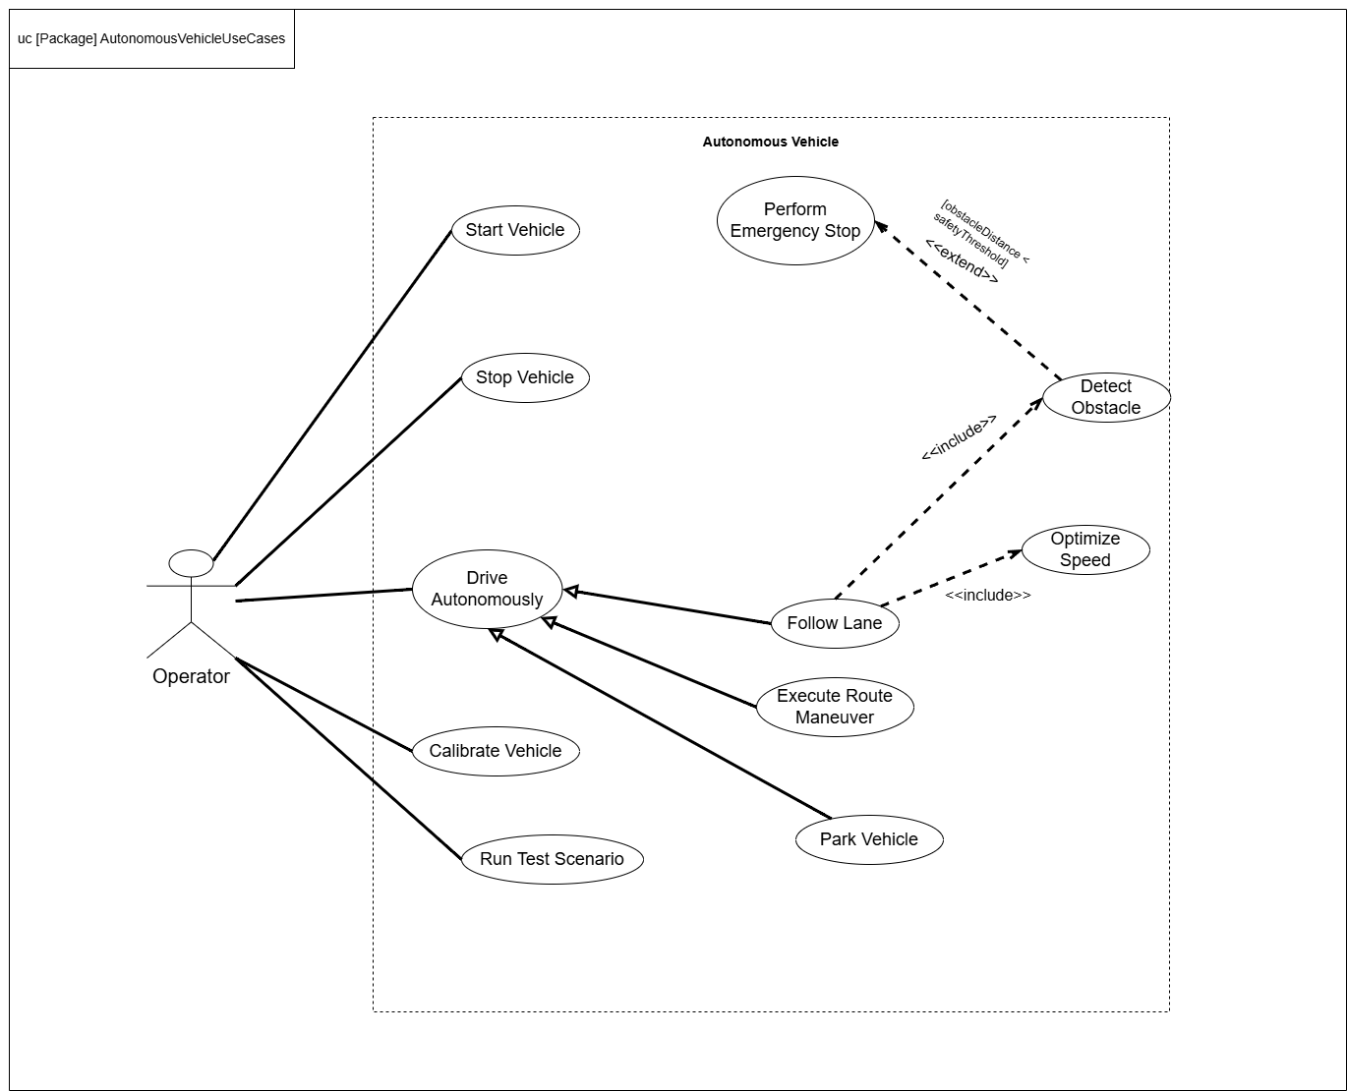
Diagrams/use_case-diagram/use_Case-D4.drawio.png
