Ye-Htet-Kyaw/Prototyping-D4-Abdelmalek-Kyaw-Forbi-Tchouteng/Firmware and Simulation/Tinkercad.png

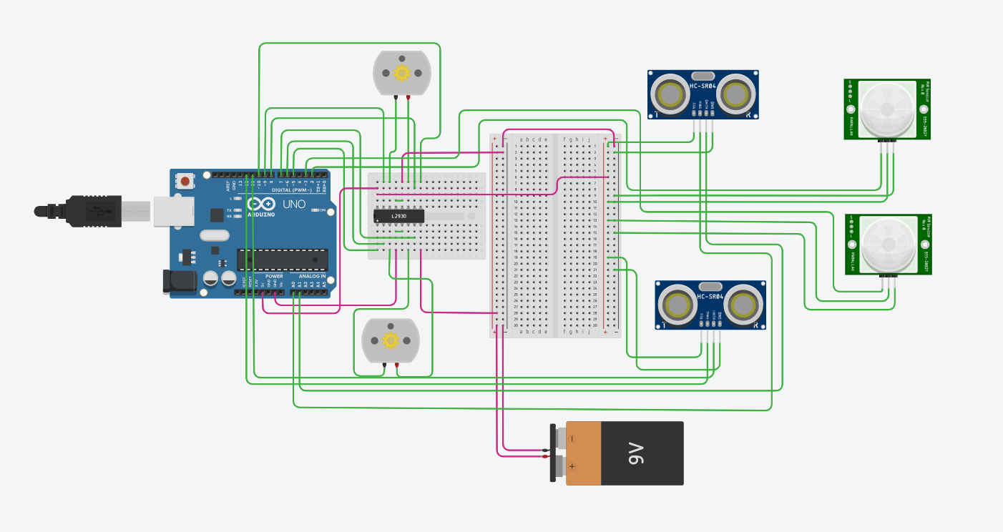
Firmware and Simulation/Tinkercad.png
