Ye-Htet-Kyaw/Prototyping-D4-Abdelmalek-Kyaw-Forbi-Tchouteng/media/photo_2026-05-31_18-38-04.jpg

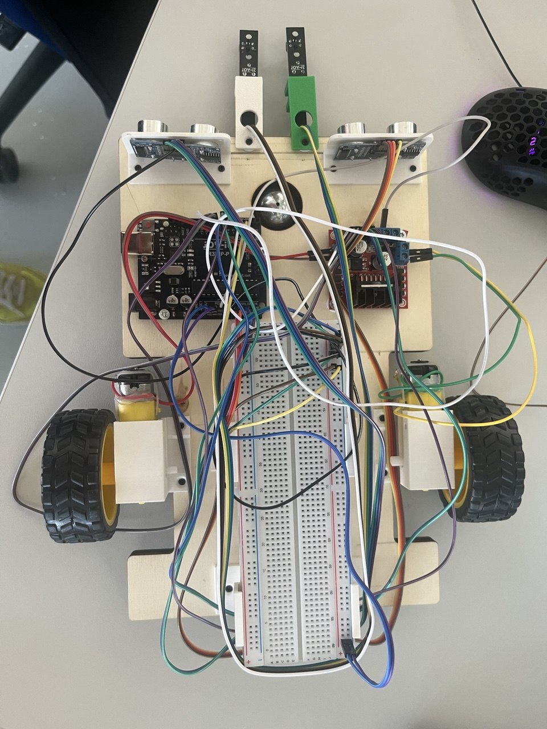
media/photo_2026-05-31_18-38-04.jpg
