Ye-Htet-Kyaw/Prototyping-D4-Abdelmalek-Kyaw-Forbi-Tchouteng/media/Version_Alpha/Screenshot 2026-06-13 010014.png

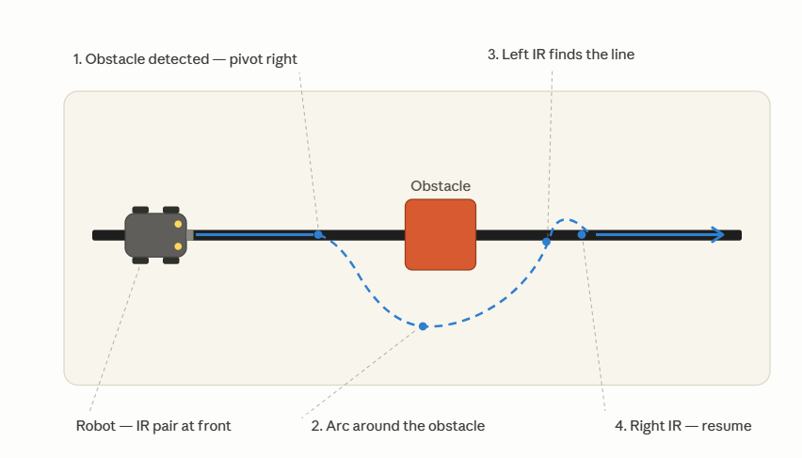
media/Version_Alpha/Screenshot 2026-06-13 010014.png
