Ye-Htet-Kyaw/Prototyping-D4-Abdelmalek-Kyaw-Forbi-Tchouteng/CAD/Battery & Board/Battery_Board_Holder_Final_RevA/Battery_&_Board_Holder_D4.STEP

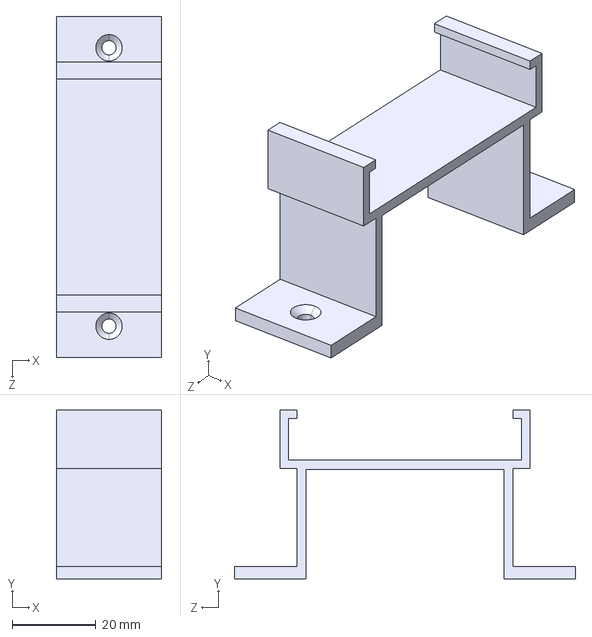
[picture p82: CAD file, 2026-05-06]
CAD/Battery & Board/Battery_Board_Holder_Final_RevA/Battery_&_Board_Holder_D4.STEP
25.0 x 40.3 x 81.4 mm
