Ye-Htet-Kyaw/Prototyping-D4-Abdelmalek-Kyaw-Forbi-Tchouteng/CAD/IR Sensor/IR_Sensor_Holder_D4.STEP

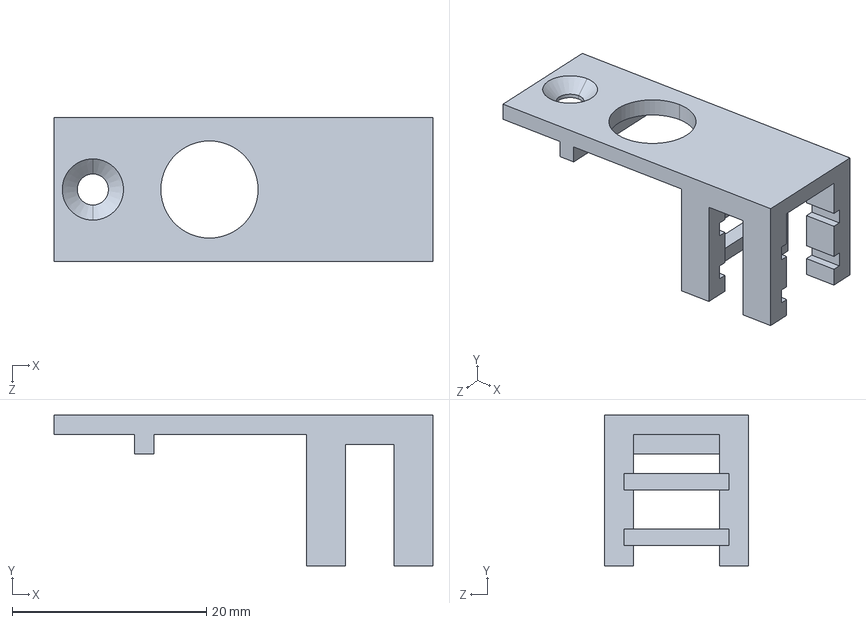
[picture p83: CAD file, 2026-07-02]
CAD/IR Sensor/IR_Sensor_Holder_D4.STEP
39.0 x 15.5 x 14.8 mm
