Ye-Htet-Kyaw/Prototyping-D4-Abdelmalek-Kyaw-Forbi-Tchouteng/CAD/motor.SLDPRT

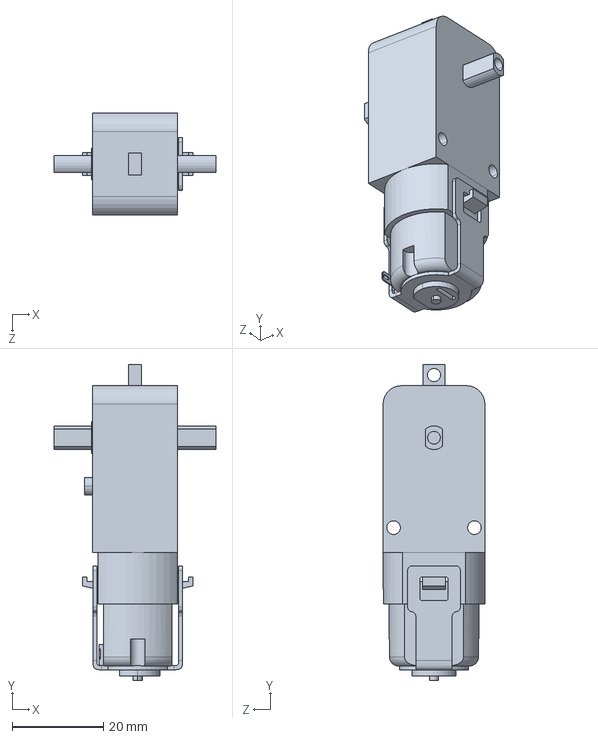
[picture p84: CAD file, 2026-05-01]
CAD/motor.SLDPRT
35.6 x 69.4 x 22.4 mm
