Ye-Htet-Kyaw/Prototyping-D4-Abdelmalek-Kyaw-Forbi-Tchouteng/CAD/Motor/Motor_Holder_Right_D4.SLDPRT

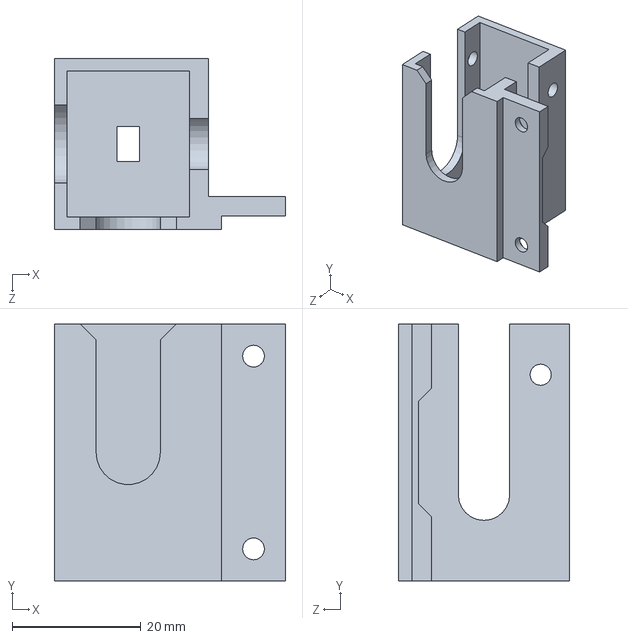
[picture p85: CAD file, 2026-05-06]
CAD/Motor/Motor_Holder_Right_D4.SLDPRT
36.0 x 40.0 x 26.6 mm
