Ye-Htet-Kyaw/Prototyping-D4-Abdelmalek-Kyaw-Forbi-Tchouteng/CAD/Ultrasonic_Sensor/Ultrasonic_Sensor_D4.STEP

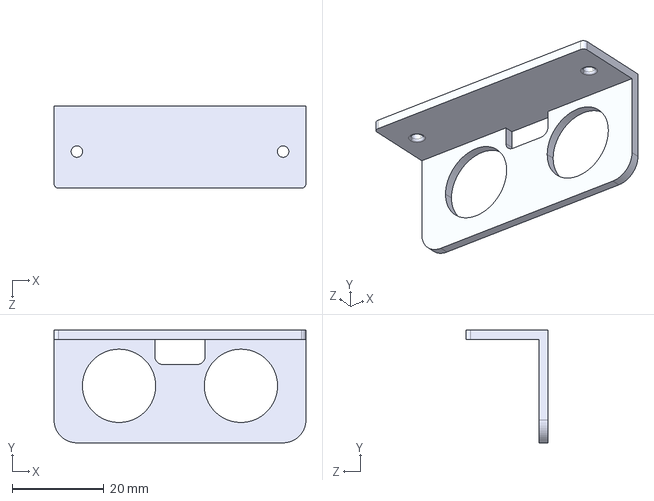
[picture p86: CAD file, 2026-05-06]
CAD/Ultrasonic_Sensor/Ultrasonic_Sensor_D4.STEP
55.0 x 24.6 x 18.0 mm
