Ye-Htet-Kyaw/Prototyping-D4-Abdelmalek-Kyaw-Forbi-Tchouteng/(list of files, cad)

Other CAD files:
CAD/Motor/Motor_Holder_Left_D4.SLDPRT
CAD/Battery & Board/Battery_Board_Holder_Final_RevA/Battery_&_Board_Holder_D4.SLDPRT
CAD/Battery & Board/Battery_Board_Holder_Final_RevA/Battery_&_Board_Holder_D4.STL
CAD/IR Sensor/IR_Sensor_Holder_D4.SLDPRT
CAD/IR Sensor/IR_Sensor_Holder_D4.STL
CAD/Ultrasonic_Sensor/Ultrasonic_Sensor_D4.SLDDRW
CAD/Ultrasonic_Sensor/Ultrasonic_Sensor_D4.SLDPRT
CAD/Ultrasonic_Sensor/Ultrasonic_Sensor_D4.STL
