Ye-Htet-Kyaw/Prototyping-D4-Abdelmalek-Kyaw-Forbi-Tchouteng/Diagrams/Test_version_Alpha/Obstacle Avoidance Flow for-2026-06-12-225232.png

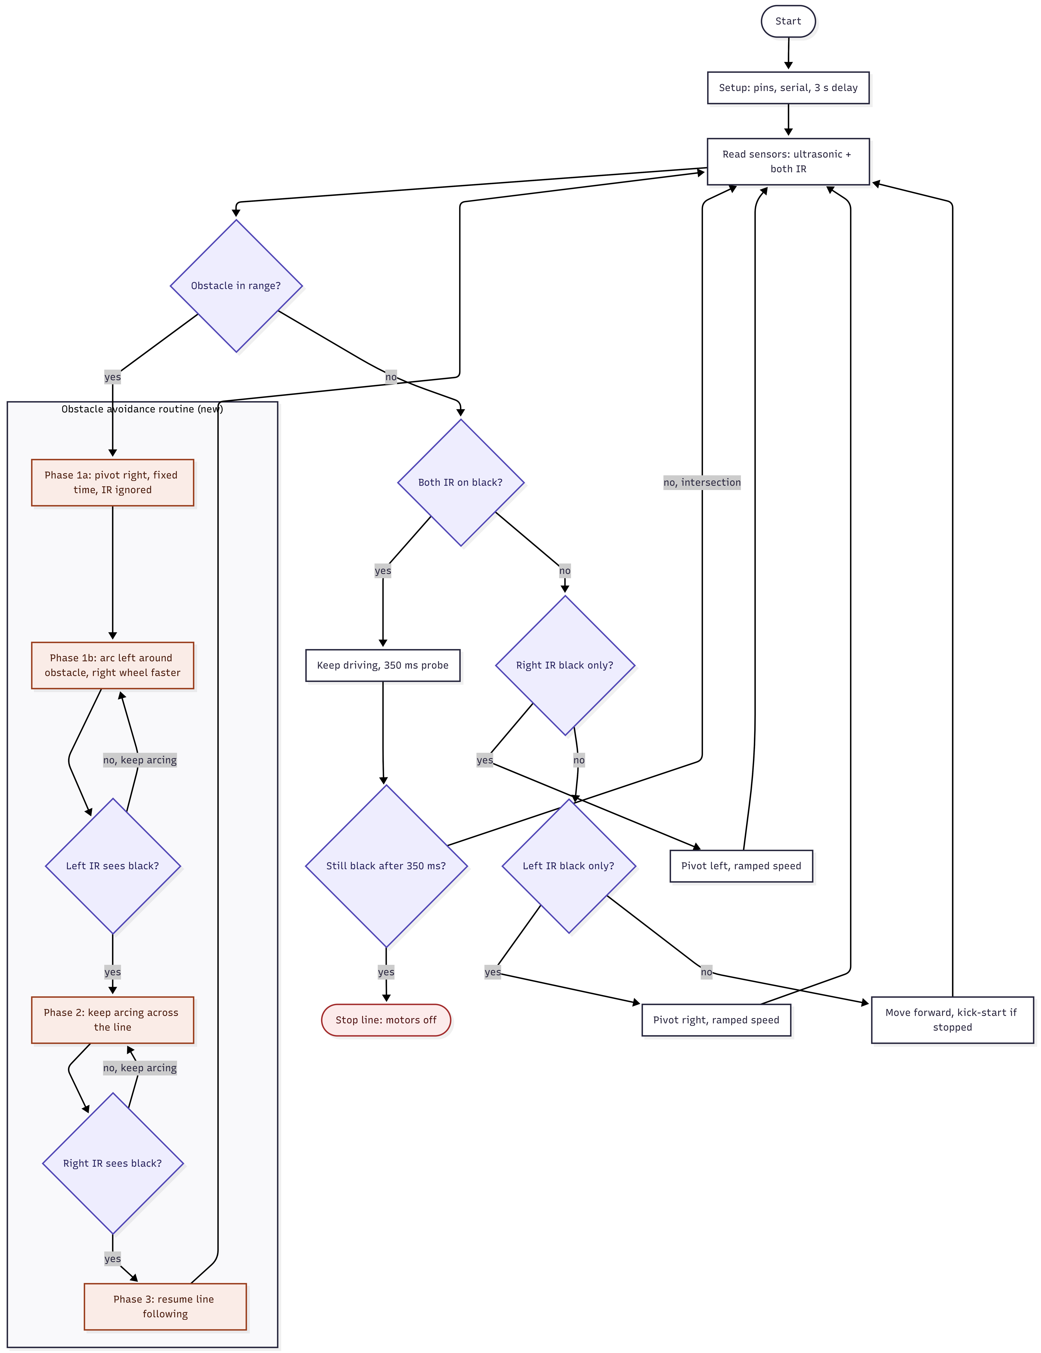
Diagrams/Test_version_Alpha/Obstacle Avoidance Flow for-2026-06-12-225232.png
