Ye-Htet-Kyaw/Prototyping-D4-Abdelmalek-Kyaw-Forbi-Tchouteng/docs/Final Presentation docs/first_draft/Team_D4.pdf

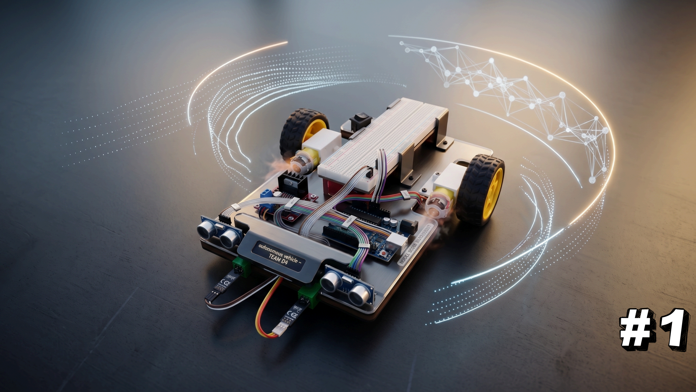
[picture p97: page 1]

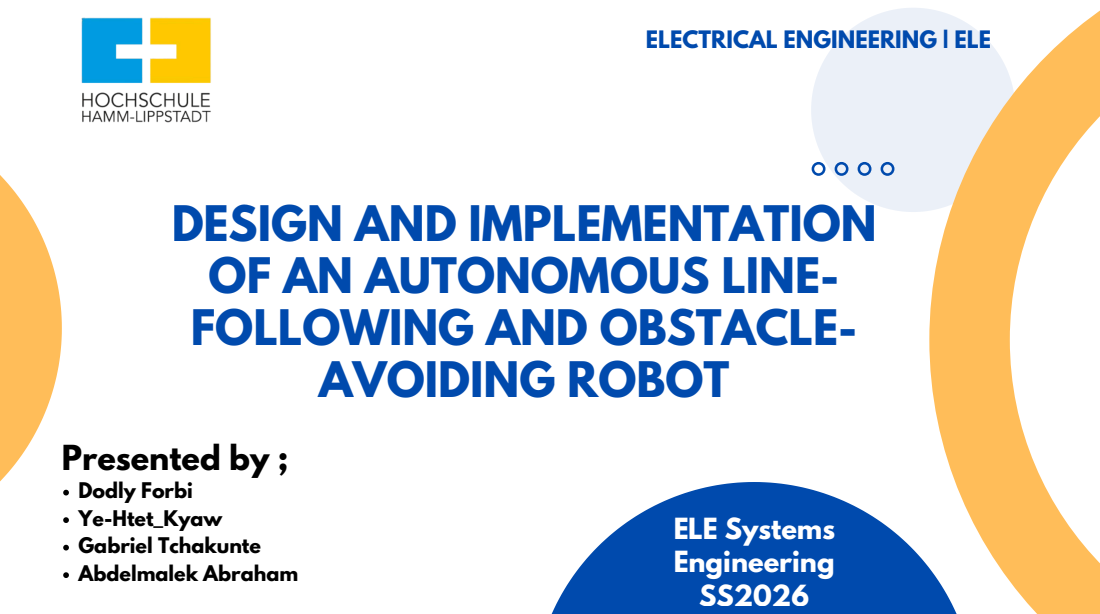
[picture p98: page 2]
Presented by ;; Dodly Forbi Ye-Htet_Kyaw Gabriel Tchakunte Abdelmalek Abraham; ELE Systems Engineering SS2026

ELECTRICAL ENGINEERING | ELE

DESIGN AND IMPLEMENTATION
OF AN AUTONOMOUS LINE-
FOLLOWING AND OBSTACLE-
AVOIDING ROBOT

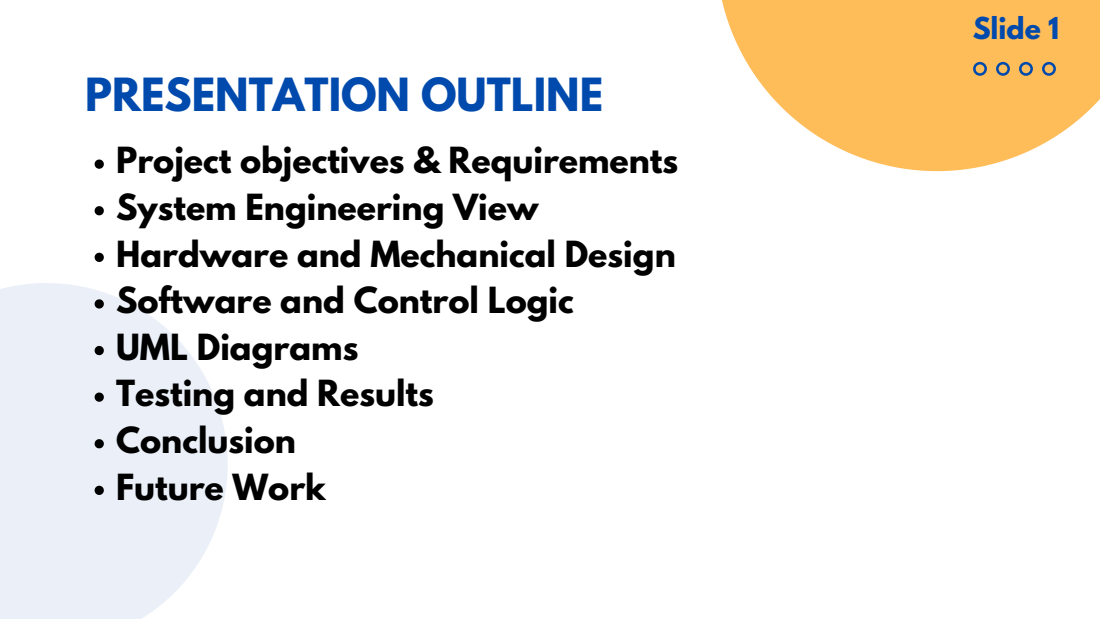
[picture p99: page 3]
Slide 1

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

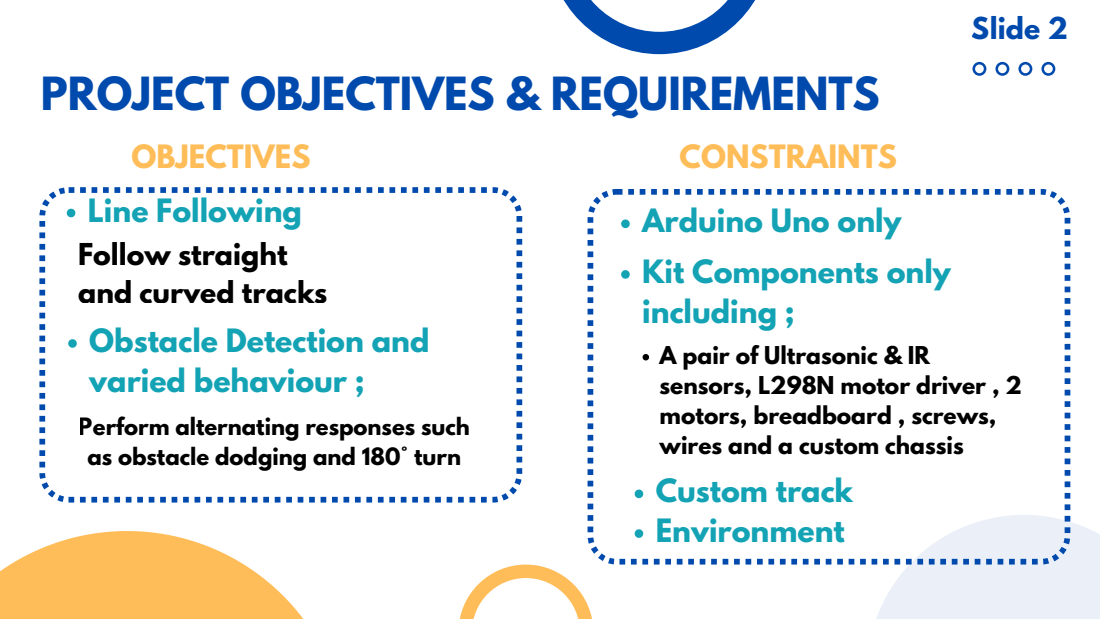
[picture p100: page 4]
Slide 2; OBJECTIVES; CONSTRAINTS

PROJECT OBJECTIVES & REQUIREMENTS

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

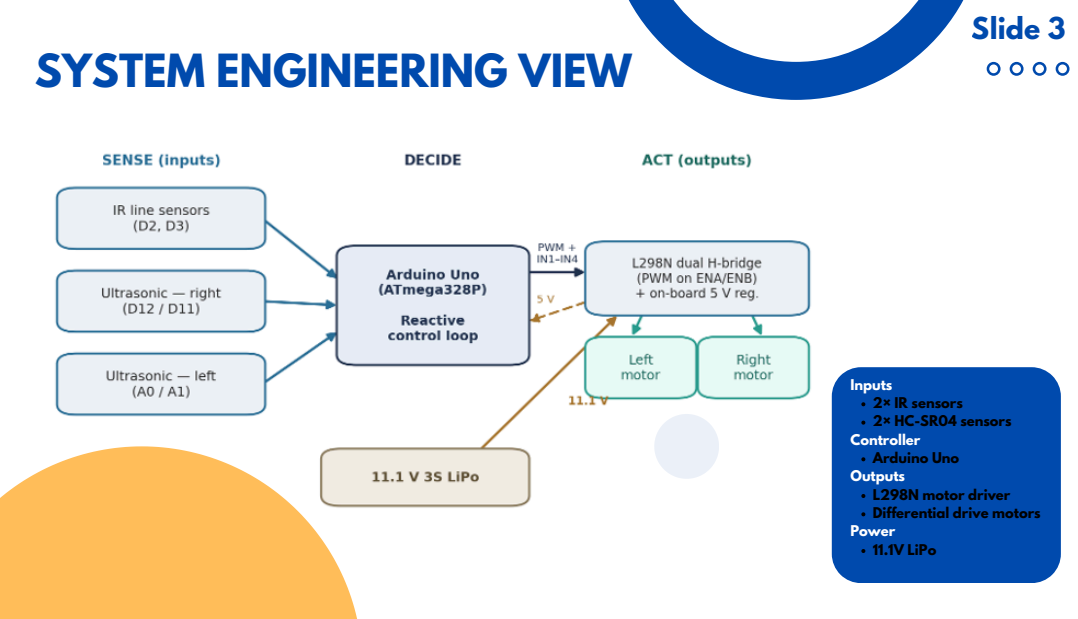
[picture p101: page 5]
Slide 3

SYSTEM ENGINEERING VIEW

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

## HARDWARE AND

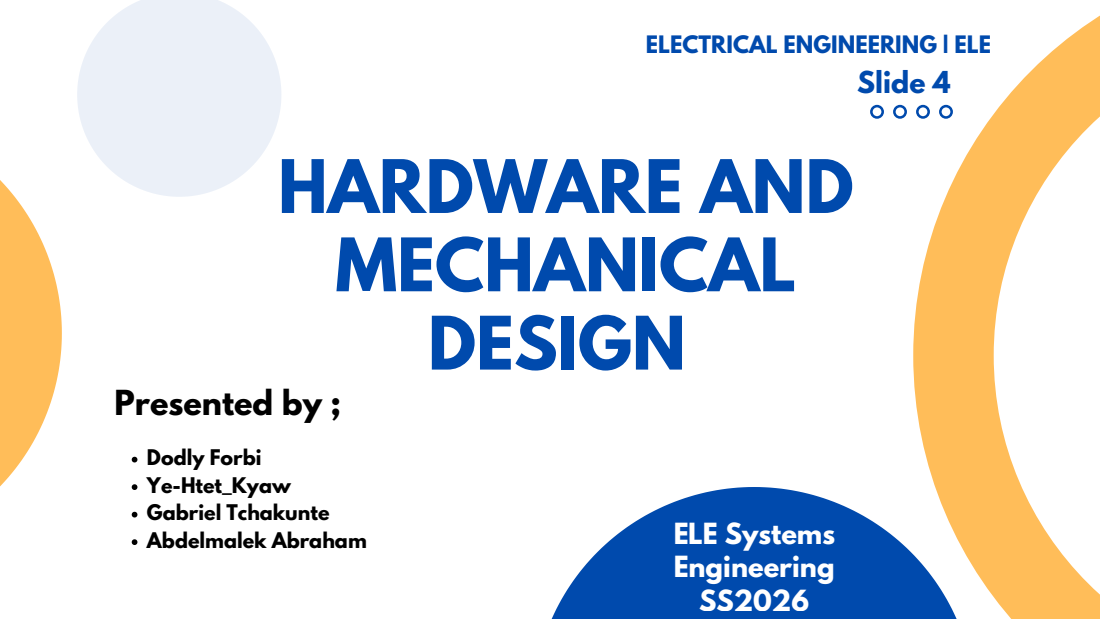
[picture p102: page 6]
MECHANICAL DESIGN; Presented by ;; Dodly Forbi Ye-Htet_Kyaw Gabriel Tchakunte; Abdelmalek Abraham; ELE Systems; Engineering SS2026; Slide 4

ELECTRICAL ENGINEERING | ELE

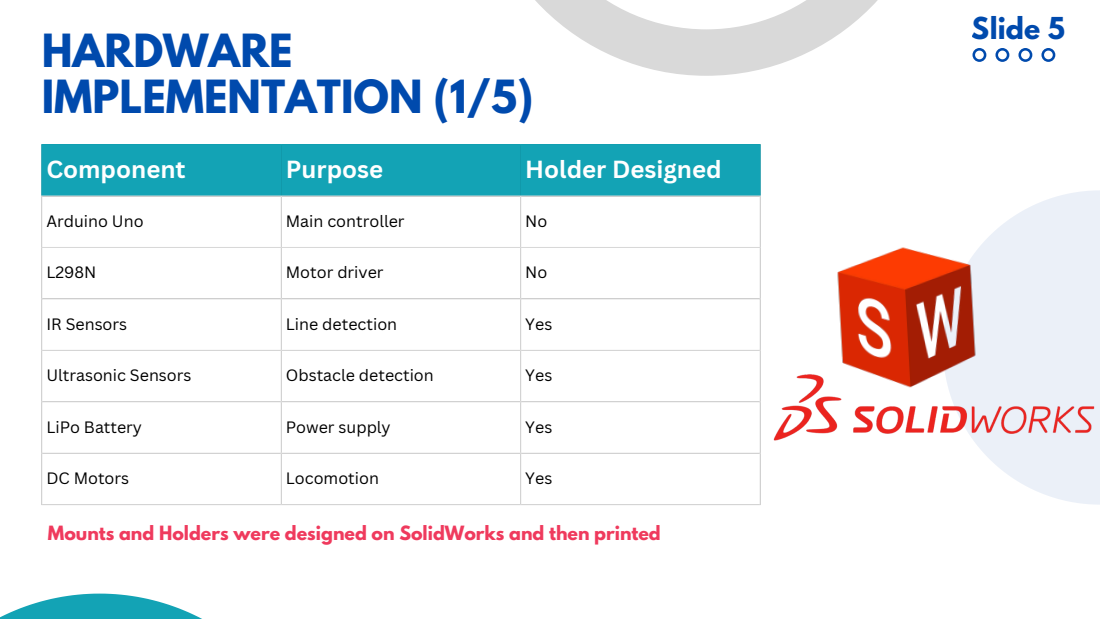
[picture p103: page 7]
HARDWARE IMPLEMENTATION (1/5); Slide 5

Component | Purpose | Holder Designed

Arduino Uno | Main controller | No

L298N | Motor driver | No

IR Sensors | Line detection | Yes

Ultrasonic Sensors | Obstacle detection | Yes

LiPo Battery | Power supply | Yes

DC Motors | Locomotion | Yes

Mounts and Holders were designed on SolidWorks and then printed

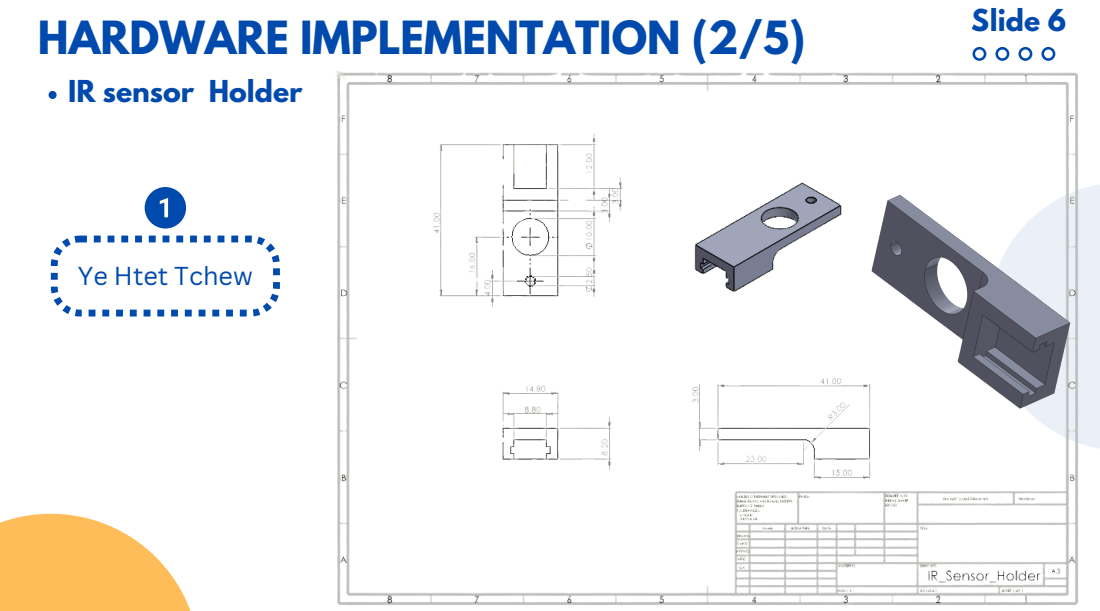
[picture p104: page 8]
Slide 6

HARDWARE IMPLEMENTATION (2/5)
IR sensor Holder

Ye Htet Tchew

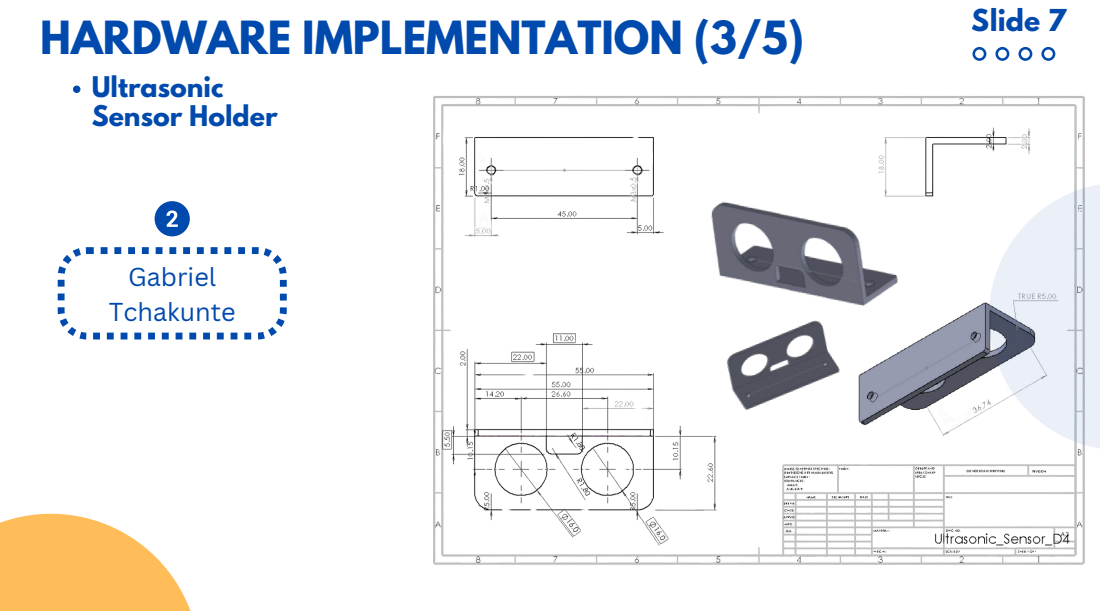
[picture p105: page 9]
Gabriel Tchakunte; HARDWARE IMPLEMENTATION (3/5); Slide 7; Ultrasonic Sensor Holder

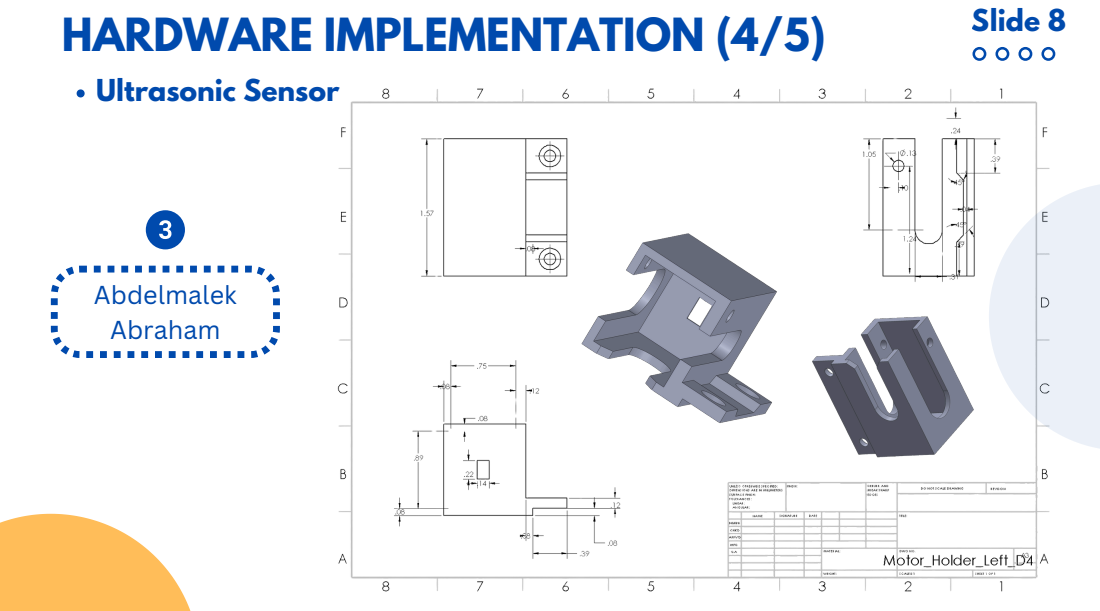
[picture p106: page 10]
Abdelmalek Abraham; HARDWARE IMPLEMENTATION (4/5); Slide 8; Ultrasonic Sensor

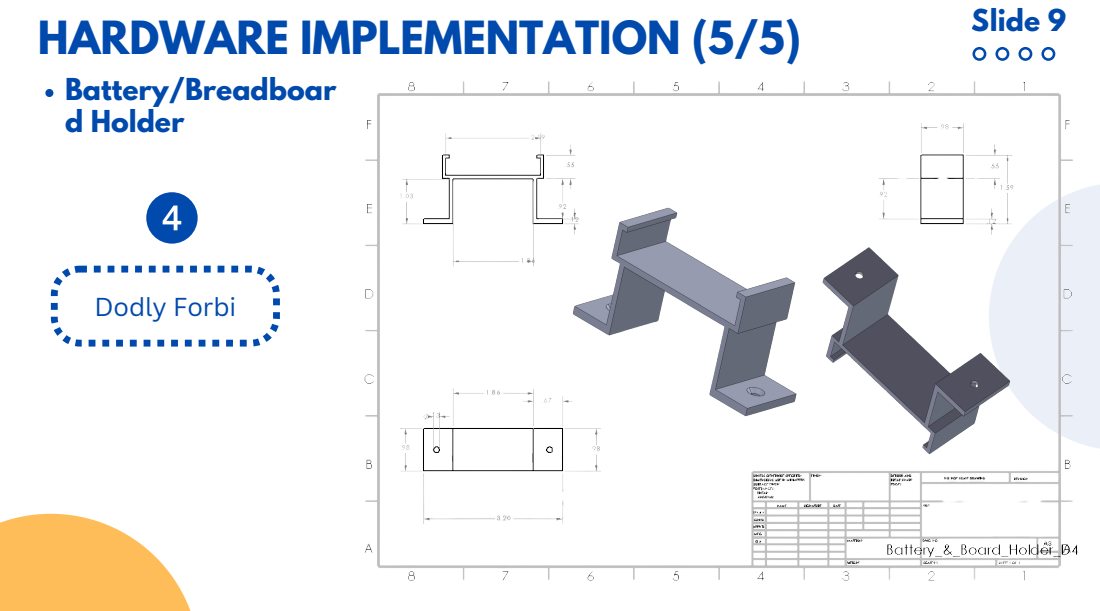
[picture p107: page 11]
Dodly Forbi; HARDWARE IMPLEMENTATION (5/5); Slide 9; Battery/Breadboar d Holder

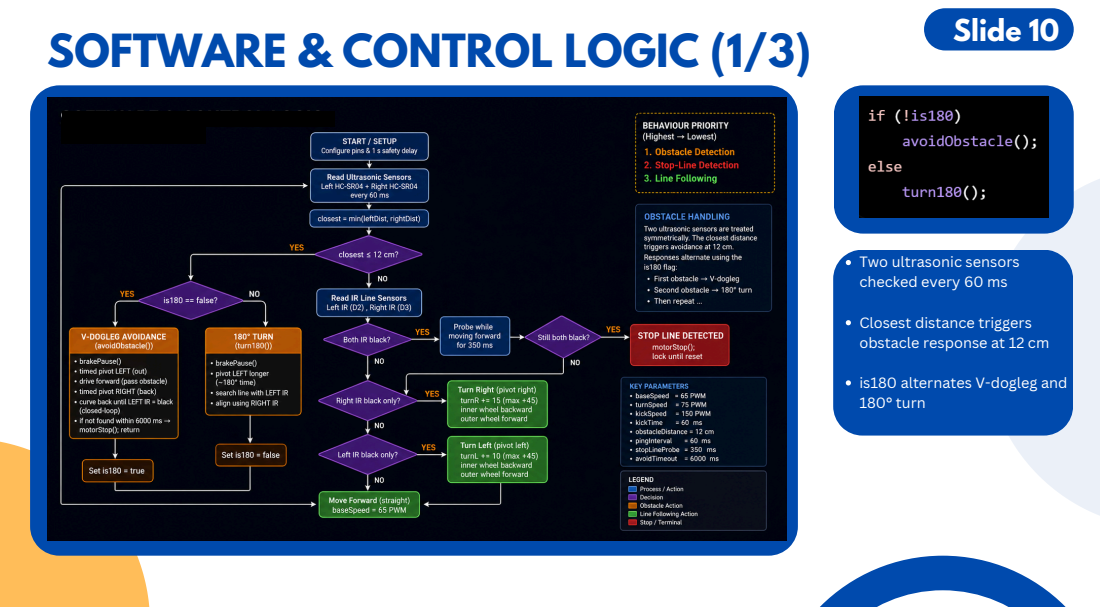
[picture p108: page 12]
Slide 10

SOFTWARE & CONTROL LOGIC (1/3)

Two ultrasonic sensors
checked every 60 ms

Closest distance triggers
obstacle response at 12 cm

is180 alternates V-dogleg and
180° turn

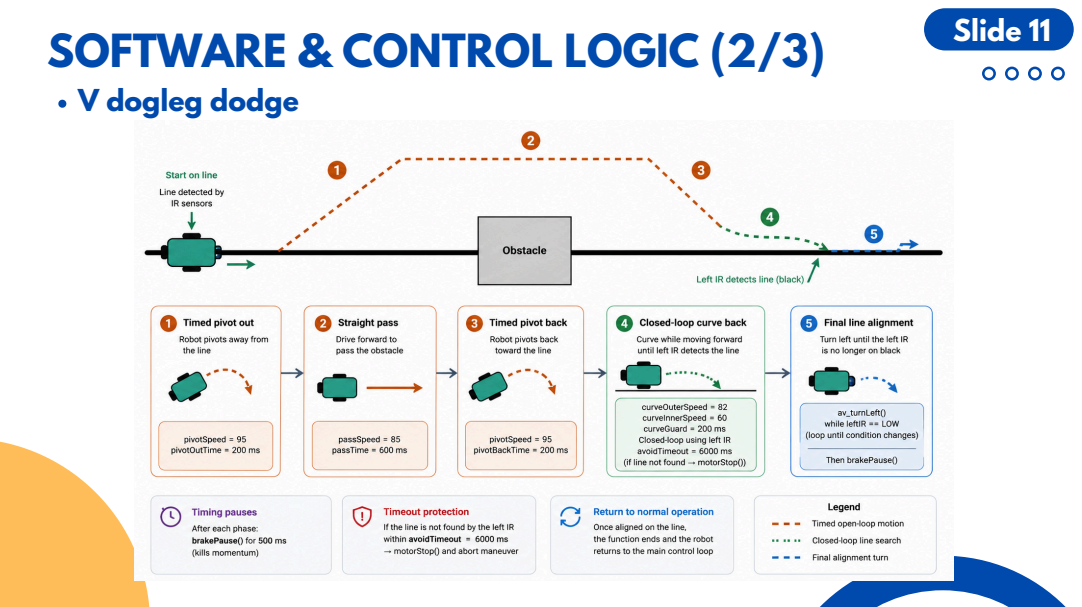
[picture p109: page 13]
Slide 11

SOFTWARE & CONTROL LOGIC (2/3)
V dogleg dodge

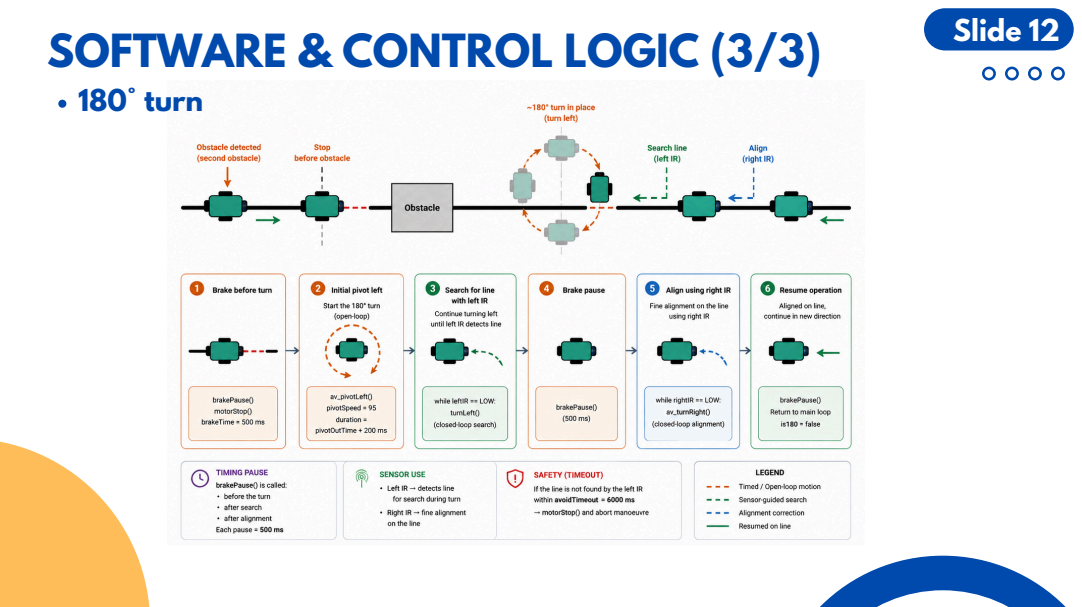
[picture p110: page 14]
Slide 12

SOFTWARE & CONTROL LOGIC (3/3)
180° turn

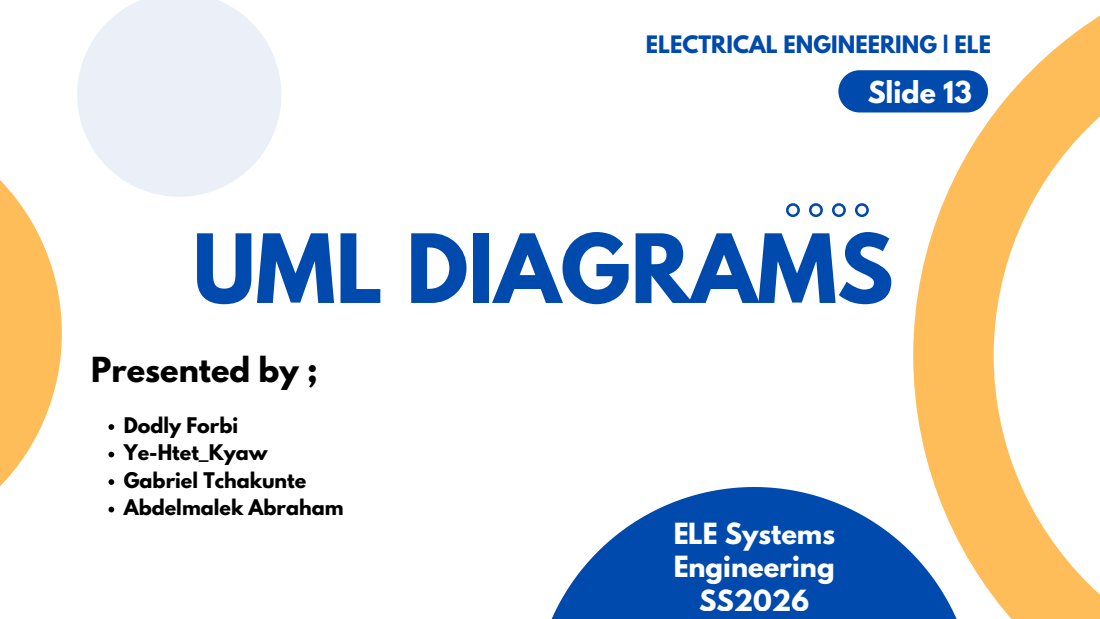
[picture p111: page 15]
UML DIAGRAMS; Presented by ;; Dodly Forbi Ye-Htet_Kyaw Gabriel Tchakunte Abdelmalek Abraham; ELE Systems Engineering SS2026; Slide 13

ELECTRICAL ENGINEERING | ELE

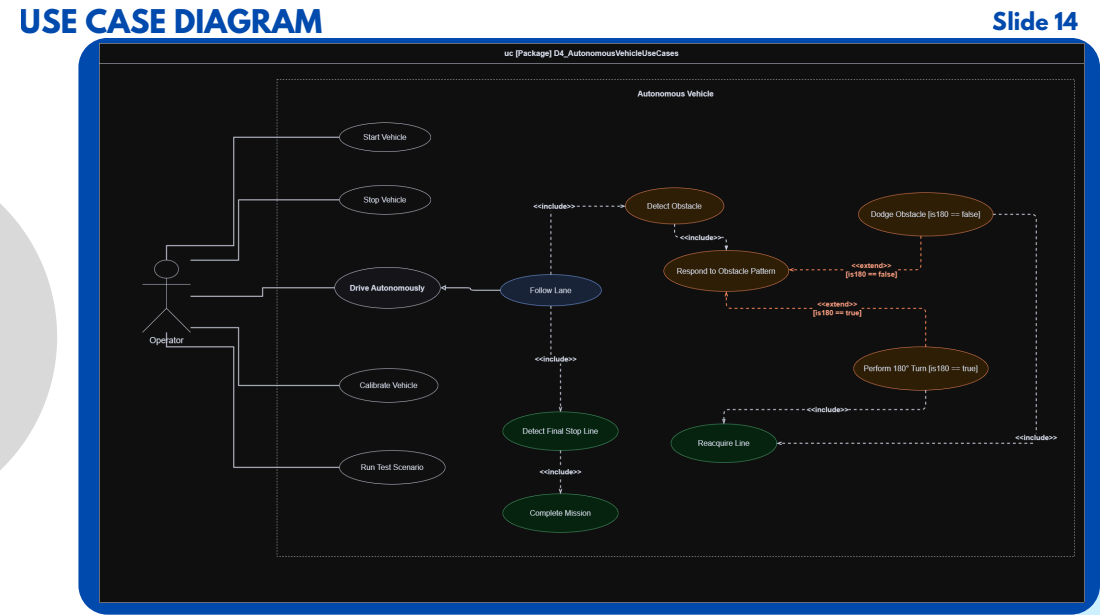
[picture p112: page 16]
USE CASE DIAGRAM; Slide 14

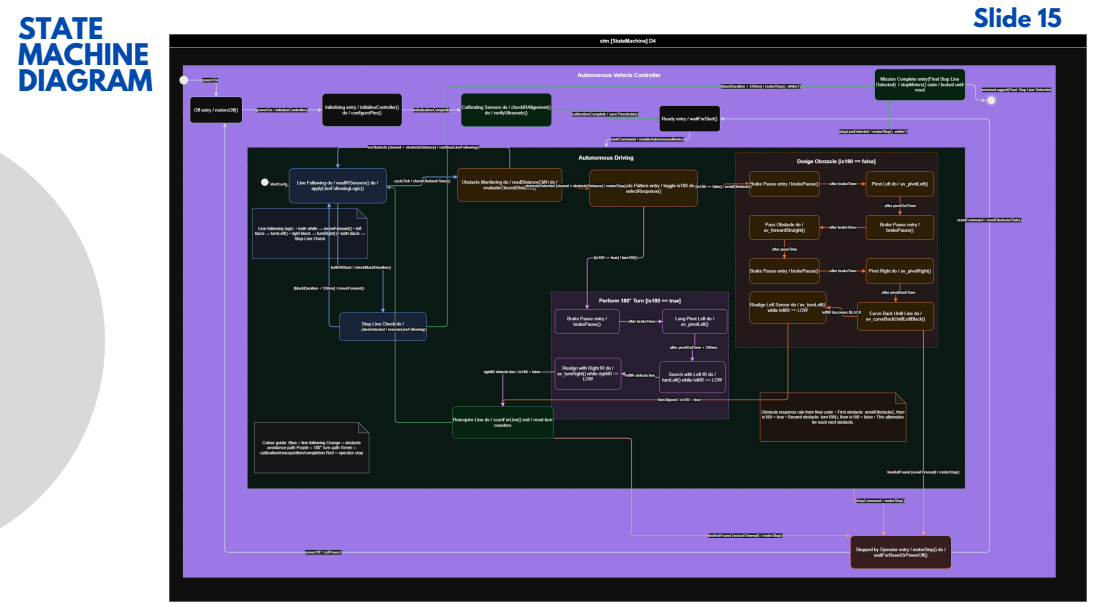
[picture p113: page 17]
Slide 15 STATE MACHINE DIAGRAM

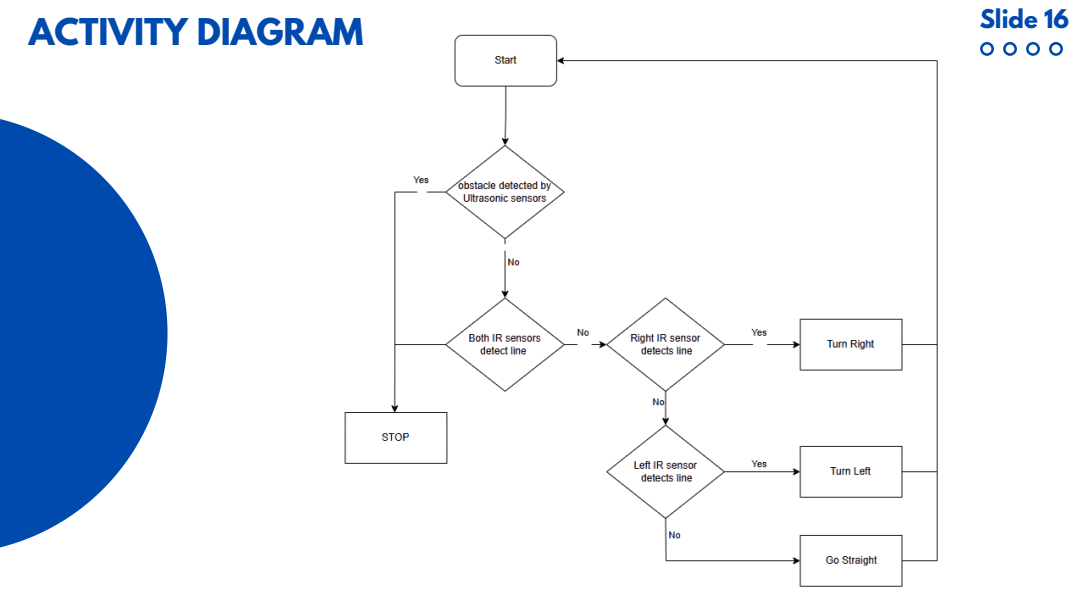
[picture p114: page 18]

Slide 16 ACTIVITY DIAGRAM

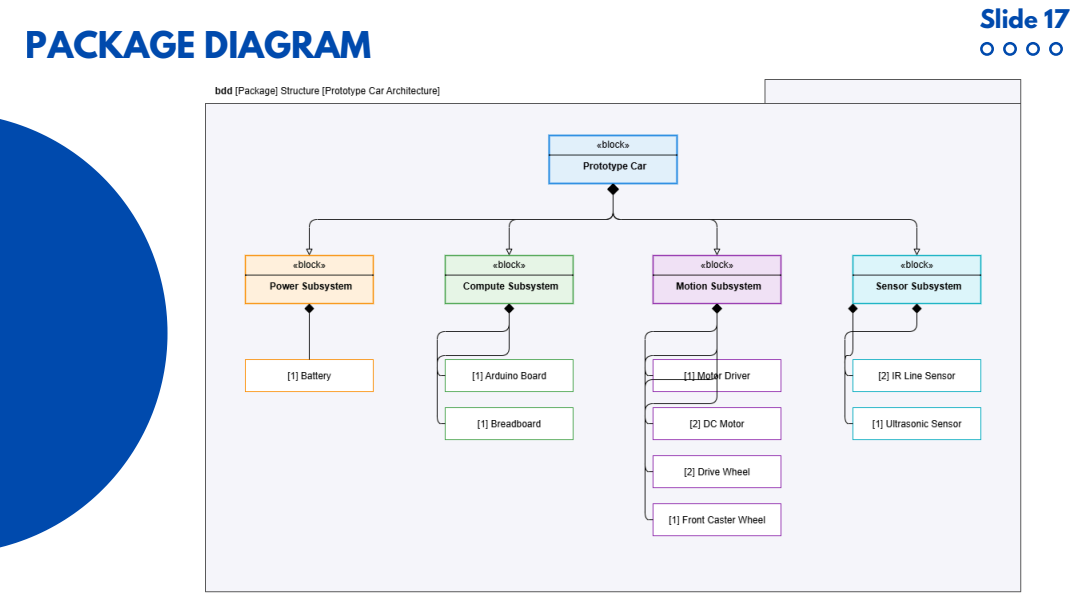
[picture p115: page 19]
Slide 17; PACKAGE DIAGRAM

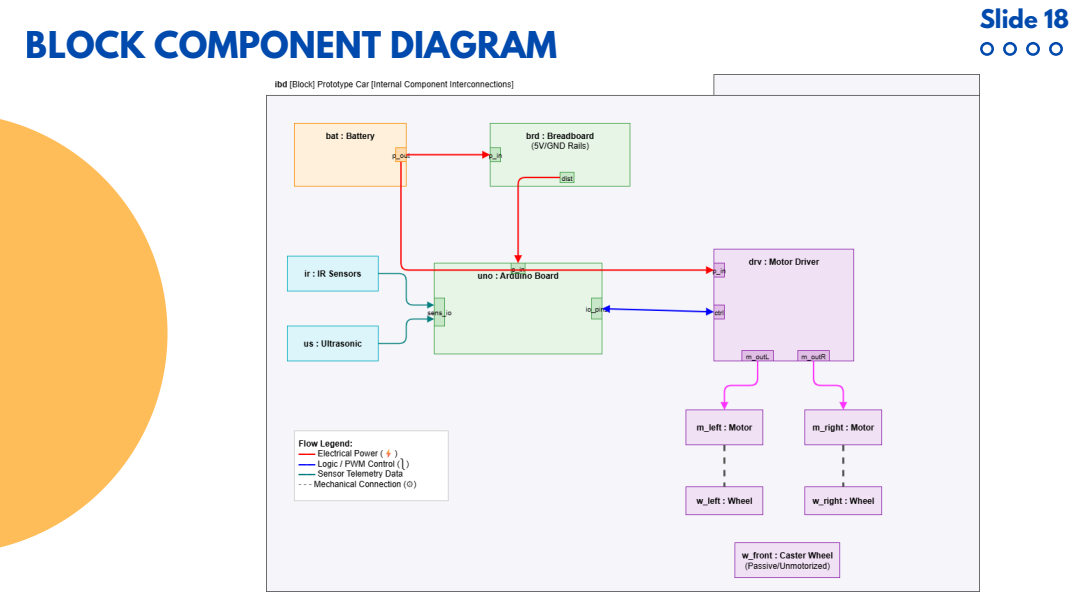
[picture p116: page 20]
Slide 18

BLOCK COMPONENT DIAGRAM

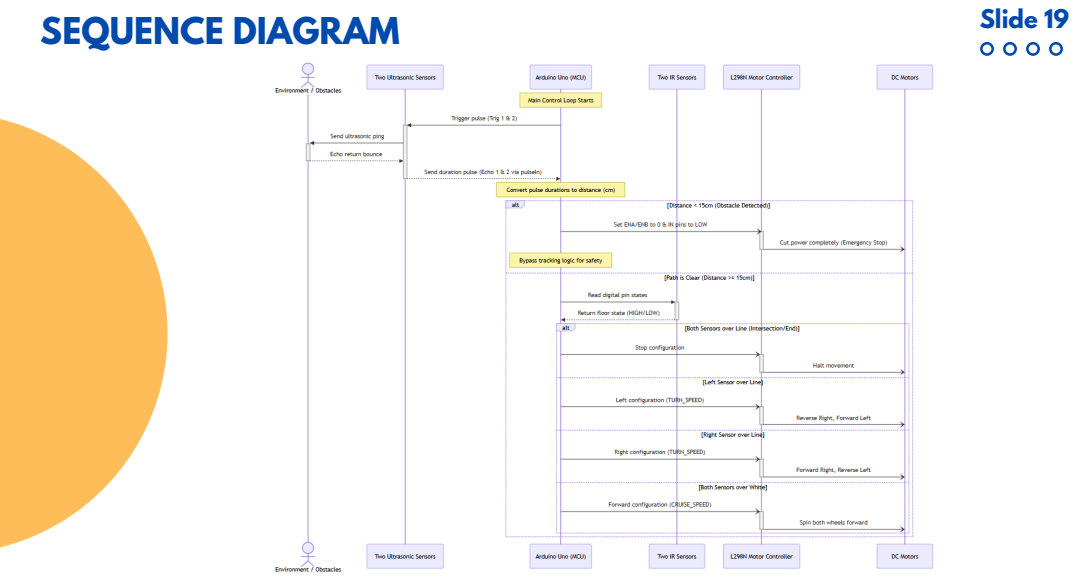
[picture p117: page 21]

Slide 19 SEQUENCE DIAGRAM

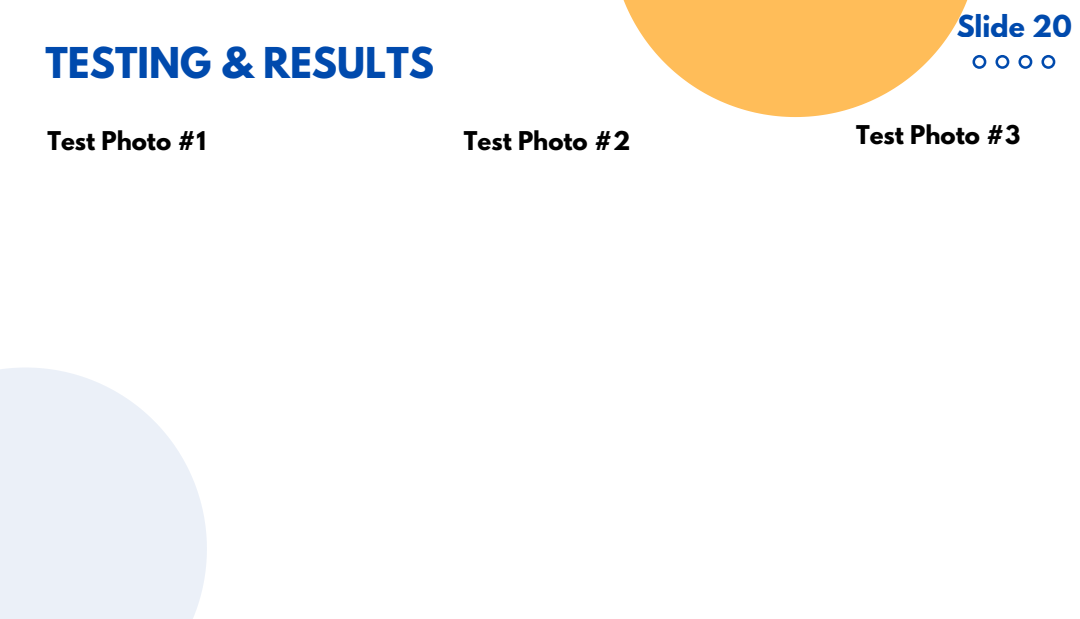
[picture p118: page 22]
Test Photo #1; TESTING & RESULTS; Slide 20; Test Photo #2; Test Photo #3

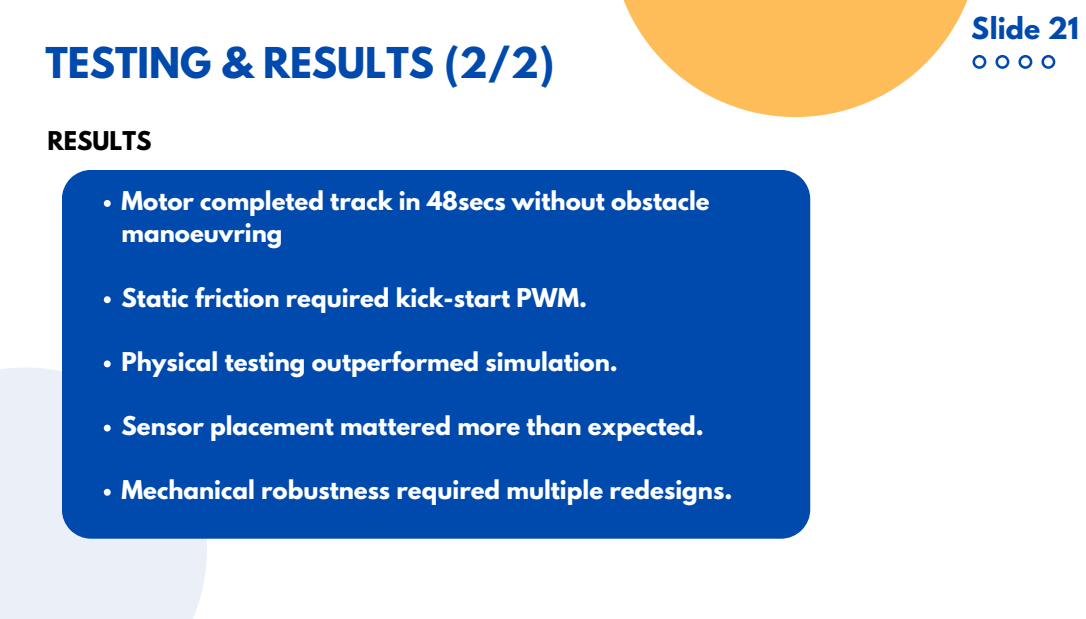
[picture p119: page 23]
RESULTS; TESTING & RESULTS (2/2); Slide 21

Motor completed track in 48secs without obstacle
manoeuvring

Static friction required kick-start PWM.

Physical testing outperformed simulation.

Sensor placement mattered more than expected.

Mechanical robustness required multiple redesigns.

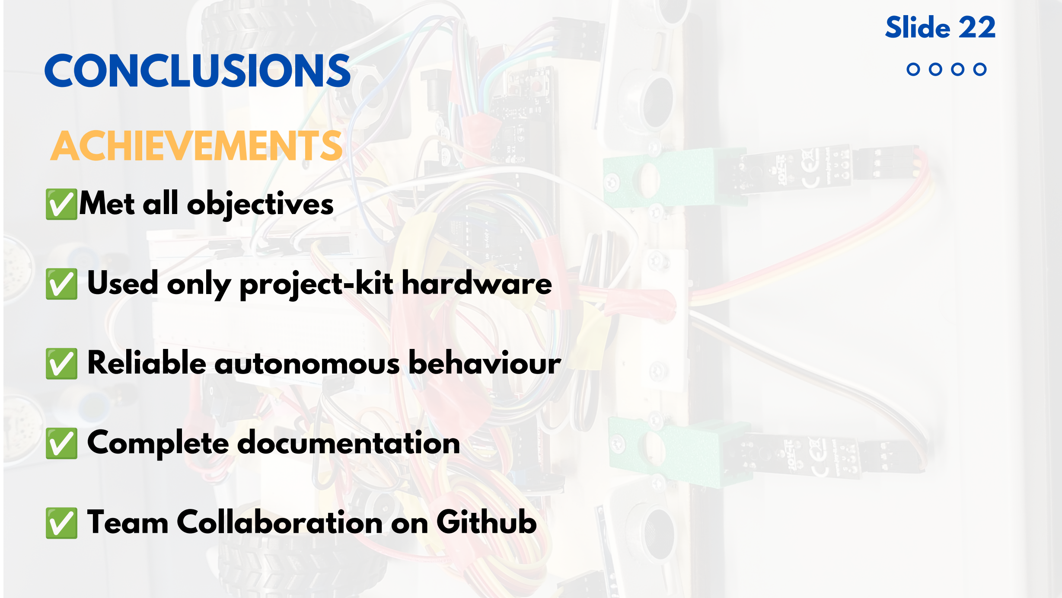
[picture p120: page 24]

✅Met all objectives

✅ Used only project-kit hardware

✅ Reliable autonomous behaviour

✅ Complete documentation

✅ Team Collaboration on Github

CONCLUSIONS

Slide 22

ACHIEVEMENTS

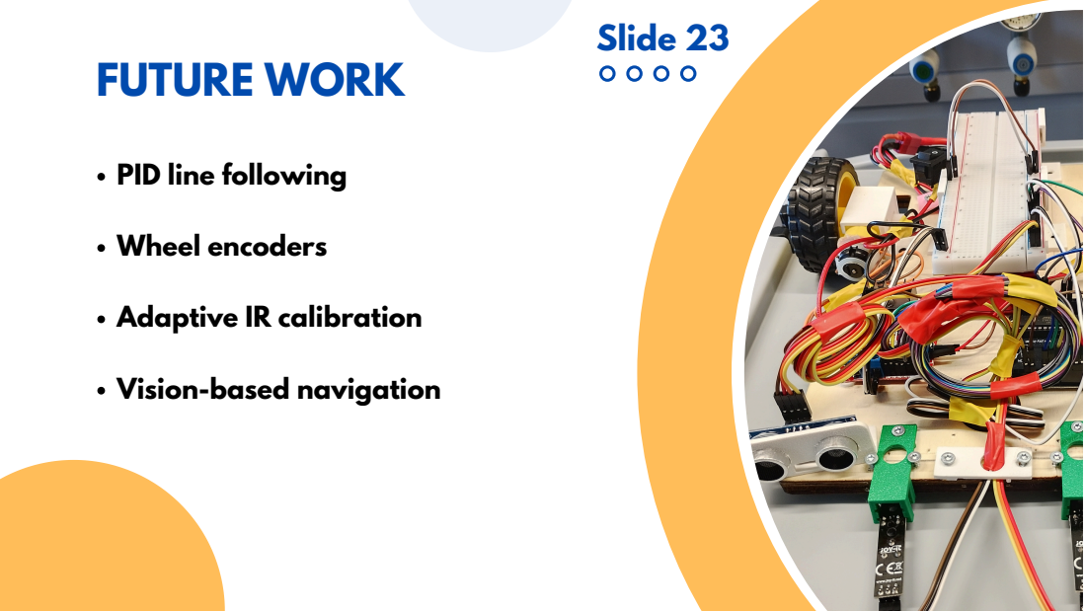
[picture p121: page 25]
Wheel encoders; FUTURE WORK; Slide 23

PID line following

Adaptive IR calibration

Vision-based navigation

# Thank

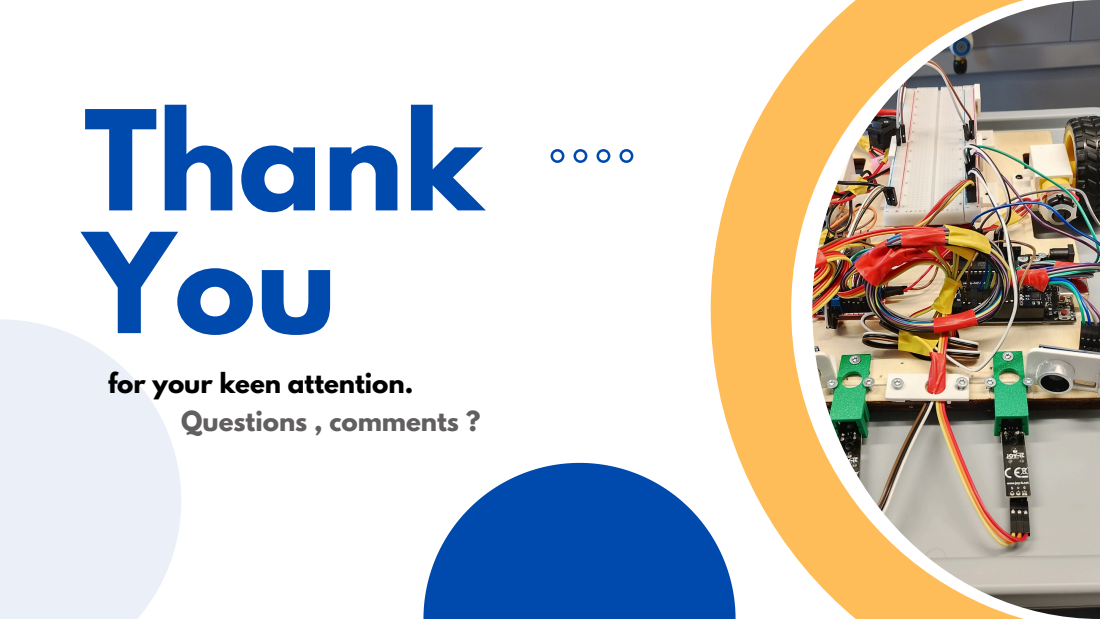
[picture p122: page 26]
You

for your keen attention.
Questions , comments ?
