Ye-Htet-Kyaw/Prototyping-D4-Abdelmalek-Kyaw-Forbi-Tchouteng/Firmware and Simulation/Earlier Versions/Final_One_File_Firmware.ino

// =================================================================
//   LINE-FOLLOWING ROBOT CAR
//   Line following + obstacle avoidance (left side)
// =================================================================

// --- PIN CONFIGURATION ---
const int ENA = 5;
const int IN1 = 6;
const int IN2 = 7;
const int IN3 = 8;
const int IN4 = 9;
const int ENB = 10;

const int leftIR = 2;
const int rightIR = 3;

// Ultrasonic sensors 
const int trigRight = 12;
const int echoRight = 11;
const int trigLeft  = A0;
const int echoLeft  = A1;

// =================================================================
//   TUNABLE SETTINGS
// =================================================================
const int baseSpeed = 65;    // Normal speed on straight line
const int turnSpeed = 75;    // Speed of the wheels during a turn

const int kickSpeed = 150;   // brief burst to START the motors
const int kickTime  = 60;    // ms the burst lasts

// --- Obstacle avoidance
const int obstacleDistance       = 18;   // cm - trigger distance
const int obstacleConfirm        = 2;    // confirmed readings before acting
const unsigned long pingInterval = 60;   // ms between ultrasonic pings

const int av_rotateSpeed             = 95;   // pivot speed for the 45-deg turns
const unsigned long rotateOutTime  = 200; // Phase 1: 45-deg rotate LEFT
const int passSpeed              = 85;   // Phase 1: speed driving past obstacle
const unsigned long passTime      = 600; // Phase 1: ~30 cm forward          
const unsigned long rotateBackTime = 200; // Phase 2: 45-deg pivot RIGHT 

const int curveOuterSpeed        = 82;   // Phase 3:
const int curveInnerSpeed        = 60;   // Phase 3:
const unsigned long curveGuard    = 200; // Phase 3: ignore IR briefly at start

const int realignSpeed           = 90;   // Phase 4: small left straighten speed
const unsigned long realignTime   = 150; // Phase 4: small left straighten  (CALIBRATE 3)
const unsigned long brakeTime     = 400; // pause between phases (kills momentum)
const unsigned long avoidTimeout  = 6000;// ms - give up if line not found

bool is180 = false;

//acceleration
int turnR = 0;
int turnL = 0;

// --- STATE / TIMING ---
bool wasMoving = false;
unsigned long lastLogTime = 0;
const unsigned long logInterval = 500;

unsigned long lastPingTime = 0;
long lastDistL = 999;
long lastDistR = 999;
int  obstacleCheckCount = 0;

void setup() {
  pinMode(ENA, OUTPUT);
  pinMode(ENB, OUTPUT);
  pinMode(IN1, OUTPUT);
  pinMode(IN2, OUTPUT);
  pinMode(IN3, OUTPUT);
  pinMode(IN4, OUTPUT);

  pinMode(leftIR, INPUT);
  pinMode(rightIR, INPUT);

  pinMode(trigRight, OUTPUT);
  pinMode(echoRight, INPUT);
  pinMode(trigLeft, OUTPUT);
  pinMode(echoLeft, INPUT);

  Serial.begin(9600);
  Serial.println("--- Robot Car Telemetry Initialized ---");
  
  // --- SAFETY START DELAY ---
  Serial.println("Starting in 1 seconds... Place robot on track!");
  delay(1000); 
  Serial.println("System GO!");
}

void loop() {

  // --- OBSTACLE CHECK (runs first, on a timer) ---
  if (millis() - lastPingTime >= pingInterval) {
    lastPingTime = millis();
    lastDistL = readDistanceCM(trigLeft, echoLeft);
    lastDistR = readDistanceCM(trigRight, echoRight);
    //long closest = min(lastDistL, lastDistR);

    if (lastDistL <= obstacleDistance && lastDistR <= obstacleDistance) obstacleCheckCount++;
    else                             obstacleCheckCount = 0;

    if (obstacleCheckCount >= obstacleConfirm) {
      obstacleCheckCount = 0;
      if(!is180){
        avoidObstacle();   // blocking maneuver, returns once back on the line
        is180 = true;
        return;            // restart the loop afterwards
      }
      else{
        turn180();
        is180 = false;
        return;
      }
    }
  }

  int leftIRState  = digitalRead(leftIR);
  int rightIRState = digitalRead(rightIR);

  // Serial Logging
  if (millis() - lastLogTime >= logInterval) {
    printSensorStatus(leftIRState, rightIRState);
    lastLogTime = millis();
  }

  // --- LINE FOLLOWING LOGIC ---
  
  // Rule 1: BOTH IR on black -> STOP
  if (leftIRState == HIGH && rightIRState == HIGH) {
  unsigned long blackStartTime = millis(); // Record when we first hit double black
    bool reachedStopLine = true;

    while (millis() - blackStartTime < 350) {
      moveForward(); 
      
      // If even ONE sensor goes back to WHITE during this time, it is an S-curve!
      if (digitalRead(leftIR) == LOW || digitalRead(rightIR) == LOW) {
        reachedStopLine = false; 
        break; 
      }
    }
    // If both sensors STILL see black after 350ms, it's an intentional stop signal
    if (reachedStopLine) {
      Serial.println("--- STOP LINE DETECTED: Shutting down motors ---");
      motorStop();
      while(1); // Infinite loop: Locks the robot here until you press Reset
    }
  }

  // Rule 2: RIGHT IR on black -> rotate turn Right
  else if (leftIRState == LOW && rightIRState == HIGH) {
    turnL = 0; // reset acceleration
    RotateTurnRight();

    if(turnR < 60) 
      turnR += 15; // accelerate
  }

  // Rule 3: LEFT IR on black -> rotate turn Left
  else if (leftIRState == HIGH && rightIRState == LOW) {
    turnR = 0;
    RotateTurnLeft();

    if(turnL < 60)
      turnL += 15;  // acceleration
  }

  // Rule 4: BOTH on white -> Go Straight
  else {

    //reset acceleration
    turnR = 0;
    turnL = 0;
    moveForward();
  }
}

// =================================================================
//   OBSTACLE AVOIDANCE  Functions
// =================================================================

void avoidObstacle() {
  //Serial.println(">>> OBSTACLE - V-dogleg detour (right)");
  
  brakePause();
  av_rotateLeft(av_rotateSpeed, rotateOutTime);     
  //Serial.println(">>> phase 1: angled out");
  brakePause();

  av_forwardStraight(passSpeed, passTime);     
  //Serial.println(">>> phase 2: passed obstacle");
  brakePause();

  av_rotateRight(av_rotateSpeed, rotateBackTime);     
  //Serial.println(">>> phase 3: aimed back");
  brakePause();

  //Serial.println(">>> phase 4: curving back, waiting for LEFT sensor...");
  if (!av_curveBackUntilLeftBlack()) {        // Phase 4: closed-loop
    //Serial.println(">>> LINE NOT FOUND - stopped (raise passTime or rotateBackTime)");
    motorStop();
    return;
  }

  //Serial.println(">>> phase 4: right sensor hit the line");
  brakePause();

  while(digitalRead(leftIR) == LOW){
    av_pivotLeft();
  }
  //Serial.println(">>> phase 5: straightened");
  brakePause();

  turnL = 0;
  turnR = 0;
  wasMoving = false;
  //Serial.println(">> resuming line following");
}
void av_pivotLeft() {
  analogWrite(ENA, turnSpeed );    // Right motor
  analogWrite(ENB, 0 );   // Left motor
  
  digitalWrite(IN1, HIGH);     // Right Forward
  digitalWrite(IN2, LOW);
  digitalWrite(IN3, LOW);      // Left backward
  digitalWrite(IN4, HIGH);
  wasMoving = true;
}

void av_pivotRight() {
  analogWrite(ENA, 0 );   // Right motor
  analogWrite(ENB, turnSpeed );  //  Left motor
  
  digitalWrite(IN1, LOW);      //  right backward
  digitalWrite(IN2, HIGH);
  digitalWrite(IN3, HIGH);     //  left Forward
  digitalWrite(IN4, LOW);
  wasMoving = true;
}

void brakePause() {
  motorStop();
  delay(brakeTime);
}

void av_rotateRight(int speed, unsigned long ms) {
  digitalWrite(IN1, LOW);
  digitalWrite(IN2, HIGH);
  digitalWrite(IN3, HIGH);
  digitalWrite(IN4, LOW);

  analogWrite(ENA, kickSpeed);
  analogWrite(ENB, kickSpeed);
  delay(kickTime);

  analogWrite(ENA, speed);
  analogWrite(ENB, speed);
  delay(ms);
  motorStop();
}

// Rotate to the physical LEFT for a fixed time.
void av_rotateLeft(int speed, unsigned long ms) {
  digitalWrite(IN1, HIGH);
  digitalWrite(IN2, LOW);
  digitalWrite(IN3, LOW);
  digitalWrite(IN4, HIGH);

  analogWrite(ENA, kickSpeed);
  analogWrite(ENB, kickSpeed);
  delay(kickTime);

  analogWrite(ENA, speed);
  analogWrite(ENB, speed);
  delay(ms);
  motorStop();
}

// Drive straight forward for a fixed time.
void av_forwardStraight(int speed, unsigned long ms) {
  digitalWrite(IN1, HIGH);
  digitalWrite(IN2, LOW);
  digitalWrite(IN3, HIGH);
  digitalWrite(IN4, LOW);

  analogWrite(ENA, kickSpeed);
  analogWrite(ENB, kickSpeed);
  delay(kickTime);

  analogWrite(ENA, speed);
  analogWrite(ENB, speed);
  delay(ms);
  motorStop();
}


bool av_curveBackUntilLeftBlack() {
  digitalWrite(IN1, HIGH);
  digitalWrite(IN2, LOW);
  digitalWrite(IN3, HIGH);
  digitalWrite(IN4, LOW);

  analogWrite(ENA, kickSpeed);
  analogWrite(ENB, kickSpeed);
  delay(kickTime);

  analogWrite(ENA, curveInnerSpeed);
  analogWrite(ENB, curveOuterSpeed);

  delay(curveGuard);   // brief blind start so we don't catch a stray reading

  unsigned long t0 = millis();
  while (digitalRead(leftIR) == LOW) {
    if (millis() - t0 > avoidTimeout) {
      motorStop();
      return false;
    }
  }
  motorStop();
  return true;
}

void turn180(){
  turnL = 0;
  turnR = 0;
  brakePause();
  av_rotateLeft(av_rotateSpeed, rotateOutTime + 200); 
  while(digitalRead(leftIR) == LOW){
    RotateTurnLeft();
  }
  brakePause();
  while(digitalRead(rightIR) == LOW){
    av_pivotRight();
  }
    
  brakePause();
}
// ===================================================================
// Sensors functions
// =====================================================================

long readDistanceCM(int trig, int echo) {
  digitalWrite(trig, LOW);
  delayMicroseconds(2);
  digitalWrite(trig, HIGH);
  delayMicroseconds(10);
  digitalWrite(trig, LOW);

  long duration = pulseIn(echo, HIGH, 8000);
  if (duration == 0) return 999;
  return duration / 58;
}

void printSensorStatus(int irL, int irR) {
  Serial.print("IR SENSORS | Left: ");
  Serial.print(irL == HIGH ? "BLACK" : "WHITE");
  Serial.print("  Right: ");
  Serial.print(irR == HIGH ? "BLACK" : "WHITE");
  Serial.print("  |  US L: ");
  if (lastDistL >= 999) Serial.print("--"); else { Serial.print(lastDistL); Serial.print("cm"); }
  Serial.print("  US R: ");
  if (lastDistR >= 999) Serial.println("--"); else { Serial.print(lastDistR); Serial.println("cm"); }
}

// =================================================================
//   MOVEMENT FUNCTIONS 
// =================================================================

void kickIfNeeded() {
  if (!wasMoving) {
    analogWrite(ENA, kickSpeed);
    analogWrite(ENB, kickSpeed);
    digitalWrite(IN1, HIGH);
    digitalWrite(IN2, LOW);
    digitalWrite(IN3, HIGH);
    digitalWrite(IN4, LOW);
    delay(kickTime);
    wasMoving = true;
  }
}

void moveForward() {
  kickIfNeeded();
  analogWrite(ENA, baseSpeed);
  analogWrite(ENB, baseSpeed);
  digitalWrite(IN1, HIGH);
  digitalWrite(IN2, LOW);
  digitalWrite(IN3, HIGH);
  digitalWrite(IN4, LOW);
}

void RotateTurnLeft() {
  analogWrite(ENA, turnSpeed + turnL);    // Right motor
  analogWrite(ENB, turnSpeed + turnL);   // Left motor
  
  digitalWrite(IN1, HIGH);     // Right Forward
  digitalWrite(IN2, LOW);
  digitalWrite(IN3, LOW);      // Left backward
  digitalWrite(IN4, HIGH);
  wasMoving = true;
}

void RotateTurnRight() {
  analogWrite(ENA, turnSpeed + turnR);   // Right motor
  analogWrite(ENB, turnSpeed + turnR);  //  Left motor
  
  digitalWrite(IN1, LOW);      //  right backward
  digitalWrite(IN2, HIGH);
  digitalWrite(IN3, HIGH);     //  left Forward
  digitalWrite(IN4, LOW);
  wasMoving = true;
}

void motorStop() {
  analogWrite(ENA, 0);
  analogWrite(ENB, 0);
  digitalWrite(IN1, LOW);
  digitalWrite(IN2, LOW);
  digitalWrite(IN3, LOW);
  digitalWrite(IN4, LOW);
  wasMoving = false;
}
