Ye-Htet-Kyaw/Prototyping-D4-Abdelmalek-Kyaw-Forbi-Tchouteng/Firmware and Simulation/Motors.h

#ifndef MOTORS_H
#define MOTORS_H

#include <Arduino.h>
#include "Config.h"

// Movement Prototypes
void motorStop();
void moveForward();
void rotateTurnLeft();
void rotateTurnRight();
void kickIfNeeded();

#endif
