Ye-Htet-Kyaw/Prototyping-D4-Abdelmalek-Kyaw-Forbi-Tchouteng/(commit log)

2026-04-22 Create CAD folder
2026-05-01 Motor Holder parts
2026-05-01 Create Battery and Board folder
2026-05-01 Create Motor folder
2026-05-01 IR Sensor Holder
    [IR_Sensor_Holder.SLDPRT, IR_Sensor_Holder.STEP, IR_Sensor_Holder.STL]
2026-05-01 Upload of initial CAD progress for battery & breadboard holder
2026-05-03 added Ultrasonic sensor drawing and STL file
    [Ultrasonic_Sensor_D4.SLDPRT, Ultrasonic_Sensor_D4.STL]
2026-05-03 Delete CAD/Ultrasonic Sensor directory
    created new directory Ultrasonic_Sensor , easier to access with command line
2026-05-06 added design tolerance for ultrasonic sensor, drwaings and new STL file
    [Ultrasonic_Sensor_D4.SLDDRW, Ultrasonic_Sensor_D4.SLDPRT, Ultrasonic_Sensor_D4.STL]
2026-05-06 add .stp file
    [Ultrasonic_Sensor_D4.STEP]
2026-05-06 Add finalized battery and board holder revision with tolerance adjustments
    [Battery_&_Board_Holder_D4.SLDPRT, Battery_&_Board_Holder_D4.STEP, Battery_&_Board_Holder_D4.STL]
2026-05-06 made updates
    [Ultrasonic_Sensor_D4.SLDPRT, Ultrasonic_Sensor_D4.STEP, Ultrasonic_Sensor_D4.STL]
2026-05-07 Final Version of IR_Sensor_Holder
    [IR_Sensor_Holder.SLDPRT, IR_Sensor_Holder.STEP, IR_Sensor_Holder.STL]
2026-05-07 add gp name
    [IR_Sensor_Holder_D4.SLDPRT]
2026-05-24 Added use case diagram
2026-05-24 Add Tinkercad vehicle prototype design
    [TinkerCAD Design-D4.brd]
2026-05-27 Tinkercad Simulation used in Lab
    [Line_Following_Robot_D4.brd]
2026-06-02 imporve structural integrity
    [IR_Sensor_Holder_D4.SLDPRT, IR_Sensor_Holder_D4.STEP, IR_Sensor_Holder_D4.STL]
2026-06-10 Arduino Code Version 3
    [Line_Following_Robot_D4.brd, TinkerCAD Design-D4.brd]
2026-06-24 line following + avoid +180 turn
    This file contains the implementation of a line-following robot car with obstacle avoidance functionality. It includes pin configurations, tunable settings, and various movement and sensor functions.
2026-06-24 Stable working release 1
    This file contains the complete code for a line-following robot car with obstacle avoidance capabilities.
    [SR_1.ino]
2026-06-24 Add files via upload
    New wiring
2026-06-30 Folder/File Organization
    [Line_Following_Robot_D4.brd, TinkerCAD Design-D4.brd]
2026-07-01 Earlier Versions Log
    [Line_Following_Robot_D4.brd, TinkerCAD Design-D4.brd]
2026-07-02 Restore Correct Version
    [IR_Sensor_Holder_D4.SLDPRT, IR_Sensor_Holder_D4.STEP, IR_Sensor_Holder_D4.STL]
2026-07-03 Add one File All-in-One firmware for line-following robot car
    This file contains the complete firmware code for a line-following robot car with obstacle avoidance features. It includes pin configurations, tunable settings, state management, and various movement and sensor functions.
    [Final_One_File_Firmware.ino]
2026-07-03 Add setup function for pin configuration
2026-07-03 Implement loop function for obstacle detection and navigation
    The main control loop that monitors sensors and manages state transitions.
2026-07-03 Implement actOnState function for motor control
    Executes logic based on the current movement state (PID control for FORWARD or turning for search).
2026-07-03 Create checkObstacle.cpp
    Periodically polls ultrasonic sensors and sets the obstacleDetected flag
2026-07-03 Add stopMotors function to stop motor control
    Safely halts all motors by setting PWM to 0 and pins to LOW
2026-07-03 Implement setMotorSpeed function for motor control
    Translates directional speeds and PWM values to the physical motor driver pins.
2026-07-03 Add getDistance function for distance measurement
    Interfaces with the ultrasonic sensor hardware to return distance in cm.
2026-07-03 Implement avoidObstacle function for obstacle navigation
    This function manages the sequence of maneuvers required to bypass an obstacle. It reverses, turns, and moves forward while continuously checking for the line or further obstacles.
    [avoidObstacle.cpp]
